xiaprojects/rb-cases/README.md

# RB-Avionics cases

3D-printable cases and mounts, and aluminium boxes, for
[RB-Avionics](https://www.rbavionics.com): open-source, open-design avionics for
experimental and ultralight aircraft and for flight simulator cockpits.

The printed designs are also published on Thingiverse:
[XIAPROJECTS designs](https://www.thingiverse.com/XIAPROJECTS/designs).

## Products

| Product | Hardware | Folder |
|---|---|---|
| RB-01: synthetic vision, autopilot, ADS-B, radio remote; round 80 mm display, or GlassCockpit with 8" and round displays | Raspberry Pi 5, Wisecoco or Waveshare display, DSI or HDMI | [RB-01](RB-01/) |
| RB-02: touch-screen SixPack for 57 mm and 80 mm panel holes | ESP32, Waveshare display | [RB-02](RB-02/) |
| RB-03: computer with autopilot, ADS-B and radio | Raspberry Pi Zero 2W | [RB-03](RB-03/) |
| RB-06: Android display, OLED or TFT | Raspberry Pi 5 with Android | [RB-06](RB-06/) |
| RB-07: commercial version, sold by Lammy | see [rbavionics.com](https://www.rbavionics.com) | [RB-07](RB-07/) |
| Flight simulator home cockpits: 3D-printable panels for RB instruments | RB-01, RB-02 family, RB-04, RB-05, RB-09 | [RB-Cockpits](RB-Cockpits/) |

RB-04 (engine monitoring) and RB-05 (Stratux traffic display) have no designs of
their own here.

## Designs

| Design | Product | Files | Author | License | Thingiverse |
|---|---|---|---|---|---|
| [3D SynthView](RB-01/3d-synthview-7162277/) | RB-01 | 12 STL | XIAPROJECTS | Personal use; commercial by agreement | [7162277](https://www.thingiverse.com/thing:7162277) |
| [F-16 sidestick grip](RB-01/f-16-sidestick-grip/) | RB-01 | 19 STL, 1 FCStd, 1 STEP | Spock | CC BY-NC-SA 4.0 | — |
| [GlassCockpit 8" unit](RB-01/glasscockpit-8/) | RB-01 | 3 STL, 1 DXF | RB-Avionics | Personal use; commercial by agreement | — |
| [GlassCockpit remote round display](RB-01/glasscockpit-round/) | RB-01 | 2 STL, 1 DXF | RB-Avionics | Personal use; commercial by agreement | — |
| [SixPack Box 80mm](RB-02/sixpack-box-80mm-7088576/) | RB-02 | 7 STL | XIAPROJECTS | Personal use; commercial by agreement | [7088576](https://www.thingiverse.com/thing:7088576) |
| [Front Install SixPack Box 80mm](RB-02/front-install-sixpack-box-80mm-7103368/) | RB-02 | 6 STL | XIAPROJECTS | Personal use; commercial by agreement | [7103368](https://www.thingiverse.com/thing:7103368) |
| [GPS mount V2](RB-02/gps-mount-v2-7169108/) | RB-02 | 2 STL | SeeCoryRun | CC BY-SA | [7169108](https://www.thingiverse.com/thing:7169108) |
| [Parrot GPS SixPack Box 80mm](RB-02/parrot-gps-sixpack-box-80mm-7208654/) | RB-02 | 2 STL | XIAPROJECTS | Personal use; commercial by agreement | [7208654](https://www.thingiverse.com/thing:7208654) |
| [SixPack Box 57mm 80mm Compact Edition](RB-02/sixpack-box-57mm-80mm-compact-edition-7228713/) | RB-02 | 2 STL | XIAPROJECTS | Personal use; commercial by agreement | [7228713](https://www.thingiverse.com/thing:7228713) |
| [Round case 57 mm, Waveshare ESP32-S3 AMOLED 1.75"](RB-02/round-case-amoled-1-75/) | RB-02 | 2 STL, 1 DXF | RB-Avionics | Personal use; commercial by agreement | — |
| [Printed case, Waveshare ESP32-S3 AMOLED 2.41"](RB-02/printed-case-amoled-2-41/) | RB-02 | 3 STL, 1 DXF | RB-Avionics | Personal use; commercial by agreement | — |
| [Aluminium Amazon box](RB-03/aluminium-amazon-box/) | RB-03 | off-the-shelf box | RB-Avionics | Personal use; commercial by agreement | — |
| [Aluminium box, Waveshare 8"](RB-06/aluminium-waveshare-8/) | RB-06 | 1 DXF | Sandro, RB-Avionics team | Personal use; commercial by agreement | — |
| [Printed case, Waveshare 8"](RB-06/printed-case-waveshare-8/) | RB-06 | 3 STL, 1 DXF | RB-Avionics | Personal use; commercial by agreement | — |
| [Printed case, Waveshare 6.25"](RB-06/printed-case-waveshare-6-25/) | RB-06 | 3 STL, 1 DXF | RB-Avionics | Personal use; commercial by agreement | — |
| [Printed case, Waveshare 5.5" AMOLED](RB-06/printed-case-waveshare-5-5-amoled/) | RB-06 | 3 STL, 1 DXF | RB-Avionics | Personal use; commercial by agreement | — |
| [Printed case, Waveshare 7" (C)](RB-06/printed-case-waveshare-7c/) | RB-06 | 3 STL, 1 DXF | RB-Avionics | Personal use; commercial by agreement | — |
| [Printed case, Waveshare 70H-1024600](RB-06/printed-case-waveshare-70h/) | RB-06 | 3 STL, 1 DXF | RB-Avionics | Personal use; commercial by agreement | — |
| [Printed case, Waveshare 7.9"](RB-06/printed-case-waveshare-7-9/) | RB-06 | 3 STL, 1 DXF | RB-Avionics | Personal use; commercial by agreement | — |
| [Printed case, Waveshare 13.3" AMOLED](RB-06/printed-case-waveshare-13-3-amoled/) | RB-06 | 6 STL, 1 DXF | RB-Avionics | Personal use; commercial by agreement | — |
| [Desktop pod](RB-Cockpits/desktop-pod/) | Cockpits | 4 STL, 1 DXF | RB-Avionics | Personal use; commercial by agreement | — |
| [Six-pack trainer](RB-Cockpits/six-pack-trainer/) | Cockpits | 13 STL, 1 DXF | RB-Avionics | Personal use; commercial by agreement | — |
| [Glass-cockpit rig](RB-Cockpits/glass-cockpit-rig/) | Cockpits | 14 STL, 3 DXF | RB-Avionics | Personal use; commercial by agreement | — |
| [Glider panel](RB-Cockpits/glider-panel/) | Cockpits | 6 STL, 1 DXF | RB-Avionics | Personal use; commercial by agreement | — |
| [Ultralight rehearsal](RB-Cockpits/ultralight-rehearsal/) | Cockpits | 11 STL, 1 DXF | RB-Avionics | Personal use; commercial by agreement | — |

To download every file of a design published on Thingiverse at once, use its
Thingiverse page.

## KiCad board templates

Every design but the round 1.75" case, which has no room for a board, and the
F-16 sidestick grip, whose switches are wired by hand, has a KiCad 9 project in
its `kicad/` folder: a board outline that fits the case,
mounting holes on the case's own bosses, and the case cut at the board plane
on the User.Drawings layer. Open it in KiCad and add your circuit;
each design README shows the board and its notes. The cockpits get a backplane
that sits behind the panel. The templates are generated by
[tools/kicad_templates.py](tools/kicad_templates.py) from the case STLs.

## Printing for aircraft

The cases are not certified aircraft parts. Printed parts installed in an
aircraft must withstand 100 °C in cruise on long flights: PLA, PETG, ABS and
ASA do not. Before printing, read [PRINTING.md](PRINTING.md) for the
materials, the print requirements and the oven test.

## Licenses

RB-Avionics designs are free for personal use; commercial use requires an
agreement with RB-Avionics. The full terms are in [LICENSE.md](LICENSE.md).

A design by another author keeps its own license in a `LICENSE.txt` in its
folder: the [GPS mount V2](RB-02/gps-mount-v2-7169108/) is by SeeCoryRun, under
CC BY-SA, and the [F-16 sidestick grip](RB-01/f-16-sidestick-grip/) is by Spock,
under CC BY-NC-SA 4.0. That grip is non-commercial: RB-Avionics cannot grant a
commercial agreement for it.

## Build guides and community

- RB-02 firmware and build tutorial: [rb-esp wiki](https://github.com/xiaprojects/rb-esp/wiki)
- RB-01 and the Raspberry Pi builds: [roastbeef wiki](https://github.com/xiaprojects/roastbeef/wiki)
- Discord: [RB-Avionics community](https://discord.gg/G4u6kjmrUG)

## Repository layout

```
RB-xx/                     one folder per product
  <design>-<thing id>/     a design published on Thingiverse
    README.md              description, parts, photos, author and license
    LICENSE.txt            only for designs by other authors
    files/                 STL files to print, DXF files to cut
    images/                renders and photos
    kicad/<project>/       KiCad board template for your own electronics
  <design>/                a design not on Thingiverse: same layout
RB-Cockpits/               simulator panels generated by tools/cockpit_panels.py
RB-0x/printed-case-*/      printed display cases generated by tools/display_cases.py
RB-02/round-case-*/        round instrument generated by tools/display_cases.py
RB-01/glasscockpit-*/      8" unit and remote round display generated by tools/display_cases.py
RB-01/f-16-sidestick-grip/ joystick grip generated by tools/joystick_grip.py
LICENSE.md                 license of the RB-Avionics designs
PRINTING.md                material requirements for parts that fly
tools/                     import, check and generator scripts
```
