xiaprojects/rb-cases/RB-01/README.md

# RB-01

Raspberry 5 with Wisecoco display or Waveshare

Supported display DSI or HDMI

## Designs

| Design | Files | Author | License |
|---|---|---|---|
| [3D SynthView](3d-synthview-7162277/): round 80 mm case | 12 STL | XIAPROJECTS | Personal use; commercial by agreement |
| [GlassCockpit 8" unit](glasscockpit-8/): the complete RB-01, one Pi 5 driving an 8" and a round display, with USB HAT, EMS HAT and every radio and antenna | 3 STL, 1 DXF | RB-Avionics | Personal use; commercial by agreement |
| [GlassCockpit remote round display](glasscockpit-round/): 80 mm round display and its driver board, 32 mm deep, on HDMI and USB cables from the 8" unit | 2 STL, 1 DXF | RB-Avionics | Personal use; commercial by agreement |
| [F-16 sidestick grip](f-16-sidestick-grip/): fighter-style joystick that drives RB-01 as a USB or Bluetooth keyboard | 19 STL, 1 FCStd, 1 STEP | Spock | CC BY-NC-SA 4.0, non-commercial |

Build guide: [roastbeef wiki, Build example 7: Round display](https://github.com/xiaprojects/roastbeef/wiki/Build-example-7:-Round-display)

Printing for an aircraft: the parts must withstand 100 °C in cruise on long flights, which rules out PLA, PETG, ABS and ASA. Read [PRINTING.md](../PRINTING.md).
