xiaprojects/rb-cases/RB-02/README.md

# RB-02

Supported Waveshare multiple format display ESP32

## Designs

| Design | Files | Author | License |
|---|---|---|---|
| [SixPack Box 80mm](sixpack-box-80mm-7088576/) | 7 STL | XIAPROJECTS | Personal use; commercial by agreement |
| [Front Install SixPack Box 80mm](front-install-sixpack-box-80mm-7103368/) | 6 STL | XIAPROJECTS | Personal use; commercial by agreement |
| [GPS mount V2](gps-mount-v2-7169108/): NEO-7M GPS shelf for the ESP32-S3 2.8" panel | 2 STL | SeeCoryRun | CC BY-SA |
| [Parrot GPS SixPack Box 80mm](parrot-gps-sixpack-box-80mm-7208654/) | 2 STL: 80 mm and 57 mm | XIAPROJECTS | Personal use; commercial by agreement |
| [SixPack Box 57mm 80mm Compact Edition](sixpack-box-57mm-80mm-compact-edition-7228713/) | 2 STL | XIAPROJECTS | Personal use; commercial by agreement |
| [Round case 57 mm, Waveshare ESP32-S3 AMOLED 1.75"](round-case-amoled-1-75/): shell and cap behind the panel, GPS hood on top | 2 STL, 1 DXF | RB-Avionics | Personal use; commercial by agreement |
| [Printed case, Waveshare ESP32-S3 AMOLED 2.41"](printed-case-amoled-2-41/): the RB-06 honeycomb case for this rectangular ESP32 display, mounted from the front of the panel | 3 STL, 1 DXF | RB-Avionics | Personal use; commercial by agreement |

57 mm and 80 mm are the standard round instrument panel holes (2¼" and 3⅛").

Build guide and firmware: [rb-esp wiki](https://github.com/xiaprojects/rb-esp/wiki)

Printing for an aircraft: the parts must withstand 100 °C in cruise on long flights, which rules out PLA, PETG, ABS and ASA. Read [PRINTING.md](../PRINTING.md).
