xiaprojects/rb-cases/RB-06/README.md

# RB-06

Big display OLED or TFT powered by Raspberry 5 with Android

## Designs

| Design | Files | Author | License |
|---|---|---|---|
| [Aluminium box, Waveshare 8"](aluminium-waveshare-8/): folded sheet aluminium | 1 DXF | Sandro, RB-Avionics team | Personal use; commercial by agreement |
| [Printed case, Waveshare 8"](printed-case-waveshare-8/): honeycomb case for the 8DP-CAPLCD with the Pi 5 and an AHRS plane, mounted from the front of the panel | 3 STL, 1 DXF | RB-Avionics | Personal use; commercial by agreement |
| [Printed case, Waveshare 6.25"](printed-case-waveshare-6-25/): the same case for the 6.25inch 720x1560 LCD, in landscape | 3 STL, 1 DXF | RB-Avionics | Personal use; commercial by agreement |
| [Printed case, Waveshare 5.5" AMOLED](printed-case-waveshare-5-5-amoled/): the same case for the 5.5inch HDMI AMOLED, with a plug bay above the display | 3 STL, 1 DXF | RB-Avionics | Personal use; commercial by agreement |
| [Printed case, Waveshare 7" (C)](printed-case-waveshare-7c/): the same case for the 7inch HDMI LCD (C), with a plug bay on the right | 3 STL, 1 DXF | RB-Avionics | Personal use; commercial by agreement |
| [Printed case, Waveshare 70H-1024600](printed-case-waveshare-70h/): the same case for the thin 7" 70H-1024600 (CT) and its HDMI adapter board | 3 STL, 1 DXF | RB-Avionics | Personal use; commercial by agreement |
| [Printed case, Waveshare 7.9"](printed-case-waveshare-7-9/): the same case for the 7.9inch HDMI LCD strip | 3 STL, 1 DXF | RB-Avionics | Personal use; commercial by agreement |
| [Printed case, Waveshare 13.3" AMOLED](printed-case-waveshare-13-3-amoled/): the same case for the 13.3inch FHD AMOLED monitor, each part in two pieces | 6 STL, 1 DXF | RB-Avionics | Personal use; commercial by agreement |
