xiaprojects/rb-cases/RB-03/README.md

# RB-03

Computer with autopilot, ADS-B and radio.

## Designs

| Design | Files | Author | License |
|---|---|---|---|
| [Aluminium Amazon box](aluminium-amazon-box/): off-the-shelf 122 × 66 × 39.5 mm box for a Raspberry Pi Zero 2W with GPS and ADS-B receiver | none, bought and drilled | RB-Avionics | Personal use; commercial by agreement |
