xiaprojects/rb-cases/RB-01/3d-synthview-7162277/files/RB01.05_-_Base_B_Meshed.stl

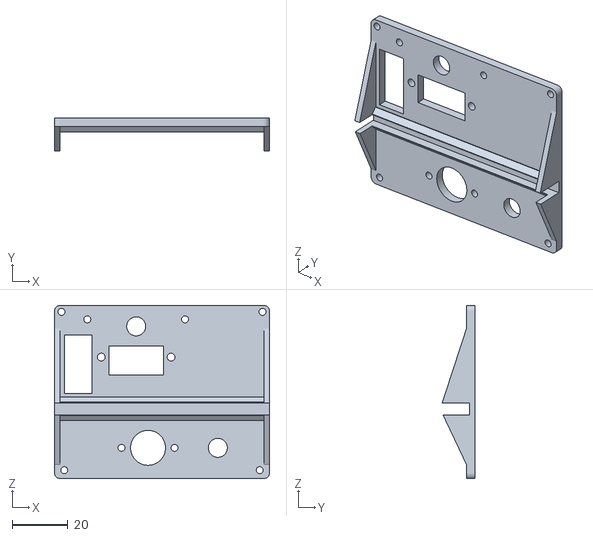
[picture p54: CAD file, 2026-10-31]
RB-01/3d-synthview-7162277/files/RB01.05_-_Base_B_Meshed.stl
77.0 x 11.7 x 62.0
