xiaprojects/rb-cases/RB-01/glasscockpit-8/files/rb01-glass-8-rear-cover.stl

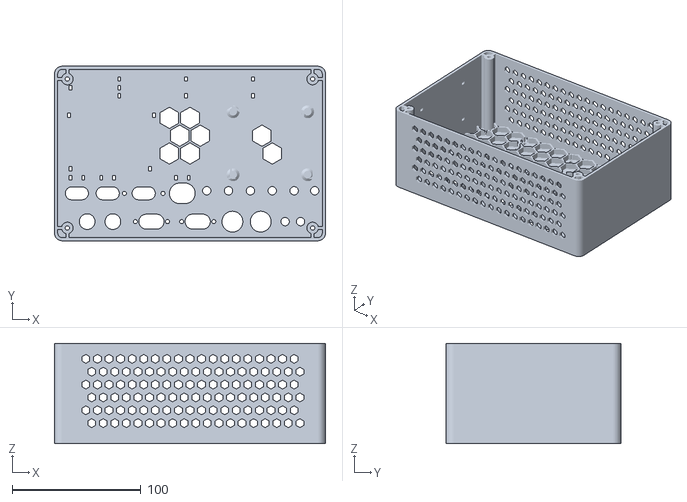
[picture p55: CAD file, 2026-11-07]
RB-01/glasscockpit-8/files/rb01-glass-8-rear-cover.stl
210.8 x 135.8 x 78.0
