xiaprojects/rb-cases/RB-01/glasscockpit-round/files/rb01-glass-round-case.FCStd

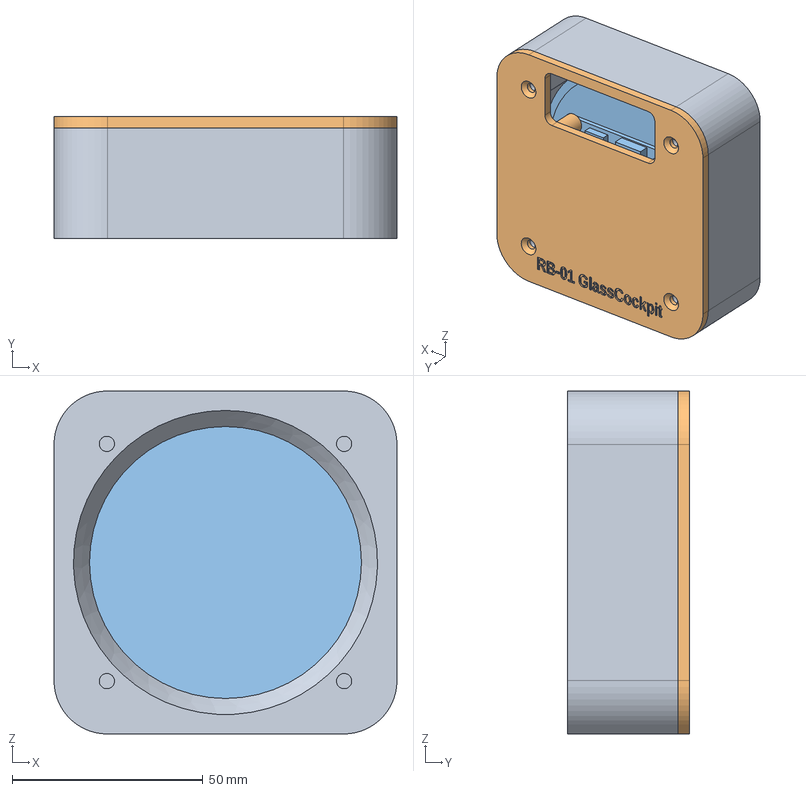
[picture p56: CAD file, 2026-11-07]
RB-01/glasscockpit-round/files/rb01-glass-round-case.FCStd
90.0 x 32.0 x 90.0 mm
Cap
Display
