xiaprojects/rb-cases/RB-02/front-install-sixpack-box-80mm-7103368/files/RB02C_-_front_ring_Meshed.stl

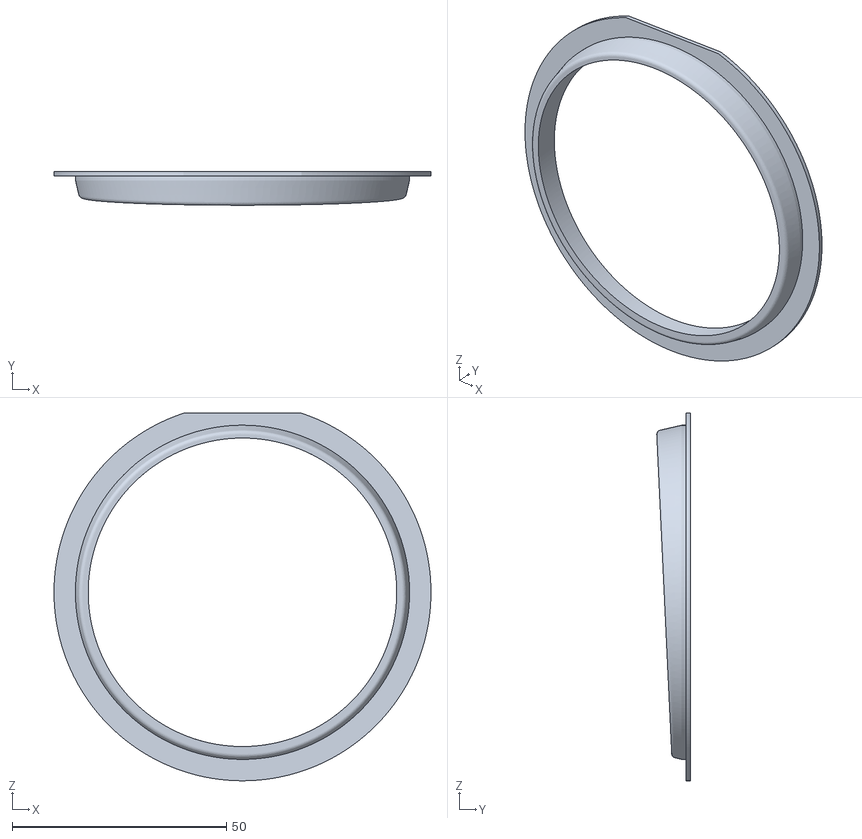
[picture p57: CAD file, 2026-10-31]
RB-02/front-install-sixpack-box-80mm-7103368/files/RB02C_-_front_ring_Meshed.stl
88.0 x 7.83 x 85.8
