xiaprojects/rb-cases/RB-02/gps-mount-v2-7169108/files/GPSstandoffV2.stl

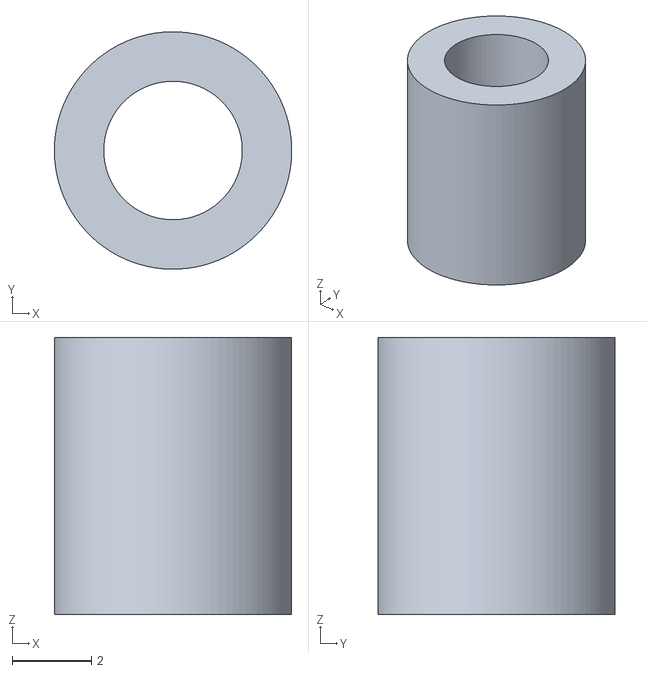
[picture p58: CAD file, 2026-10-31]
RB-02/gps-mount-v2-7169108/files/GPSstandoffV2.stl
6.00 x 6.00 x 7.00
