xiaprojects/rb-cases/RB-02/parrot-gps-sixpack-box-80mm-7208654/files/RB02B_-_2.1_-_57mm.stl

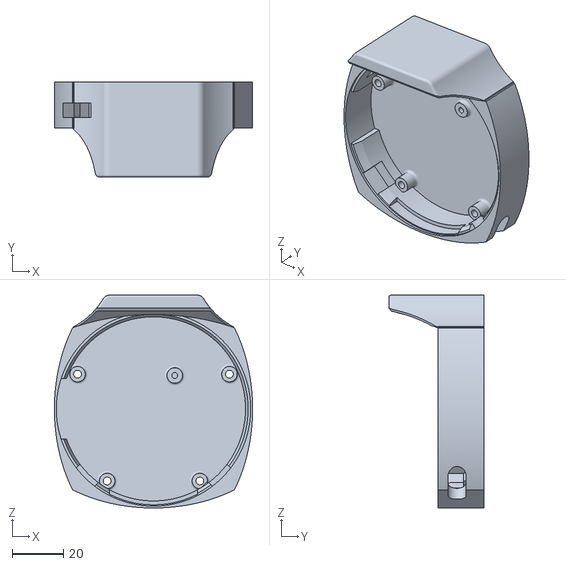
[picture p59: CAD file, 2026-10-31]
RB-02/parrot-gps-sixpack-box-80mm-7208654/files/RB02B_-_2.1_-_57mm.stl
77.0 x 37.0 x 82.7
