xiaprojects/rb-cases/RB-02/printed-case-amoled-2-41/files/rb02-amoled241-carrier.stl

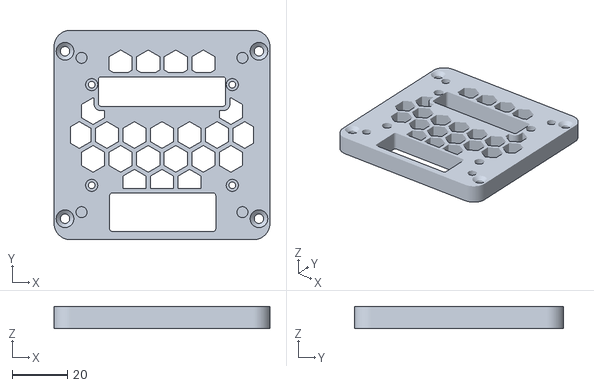
[picture p60: CAD file, 2026-11-01]
RB-02/printed-case-amoled-2-41/files/rb02-amoled241-carrier.stl
78.4 x 76.0 x 8.00
