xiaprojects/rb-cases/RB-02/round-case-amoled-1-75/files/rb02-amoled175-panel-cutout.dxf

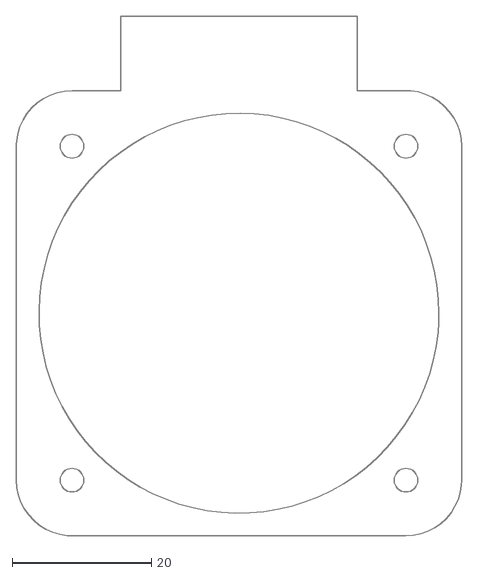
[picture p61: CAD file, 2026-11-01]
RB-02/round-case-amoled-1-75/files/rb02-amoled175-panel-cutout.dxf
64.0 x 74.7
