xiaprojects/rb-cases/RB-02/sixpack-box-57mm-80mm-compact-edition-7228713/files/RB02Bep50_2.2.stl

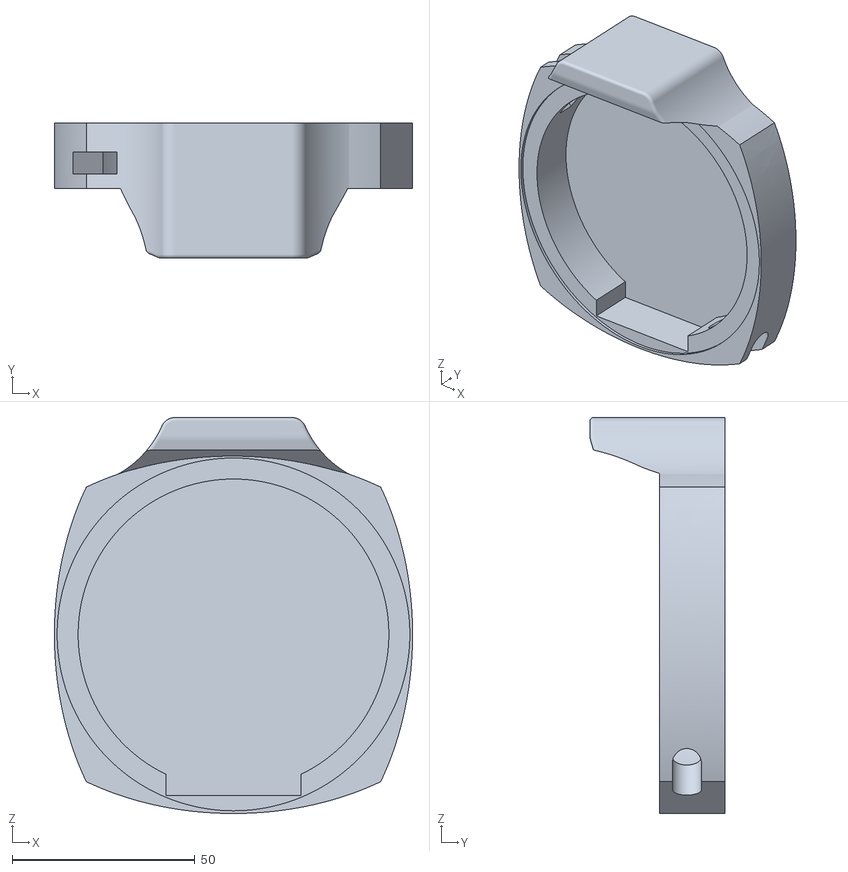
[picture p62: CAD file, 2026-10-31]
RB-02/sixpack-box-57mm-80mm-compact-edition-7228713/files/RB02Bep50_2.2.stl
98.0 x 37.0 x 108.3
