xiaprojects/rb-cases/RB-06/aluminium-waveshare-8/files/RB_Box_WS8inch_v3.dxf

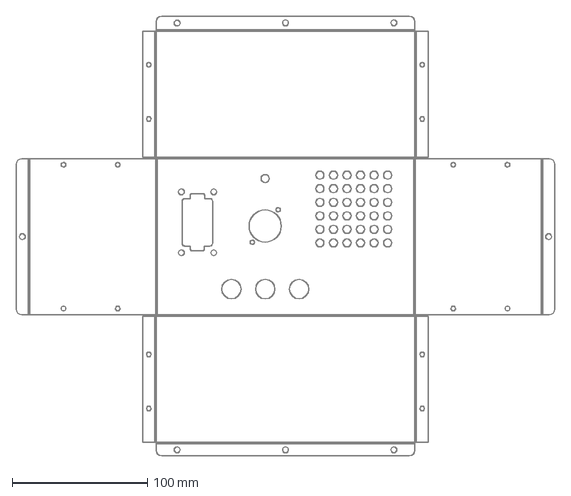
[picture p64: CAD file, 2026-10-31]
RB-06/aluminium-waveshare-8/files/RB_Box_WS8inch_v3.dxf
397.5 x 324.7 mm
