xiaprojects/rb-cases/RB-06/printed-case-waveshare-13-3-amoled/files/rb06-133amoled-bezel-left.stl

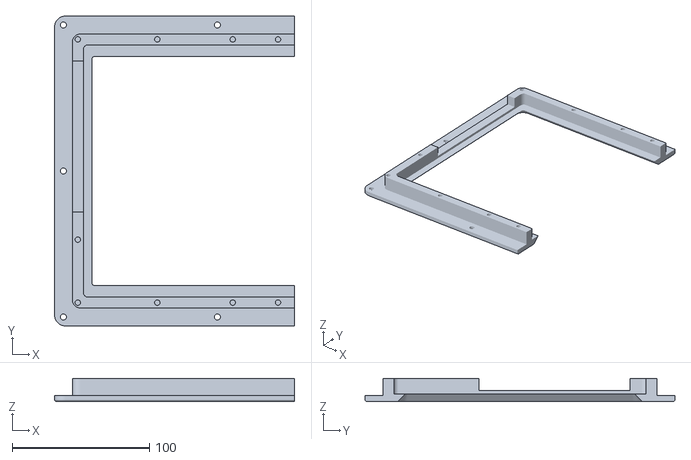
[picture p65: CAD file, 2026-11-01]
RB-06/printed-case-waveshare-13-3-amoled/files/rb06-133amoled-bezel-left.stl
174.9 x 225.8 x 16.9
