xiaprojects/rb-cases/RB-06/printed-case-waveshare-6-25/files/rb06-625-case.FCStd

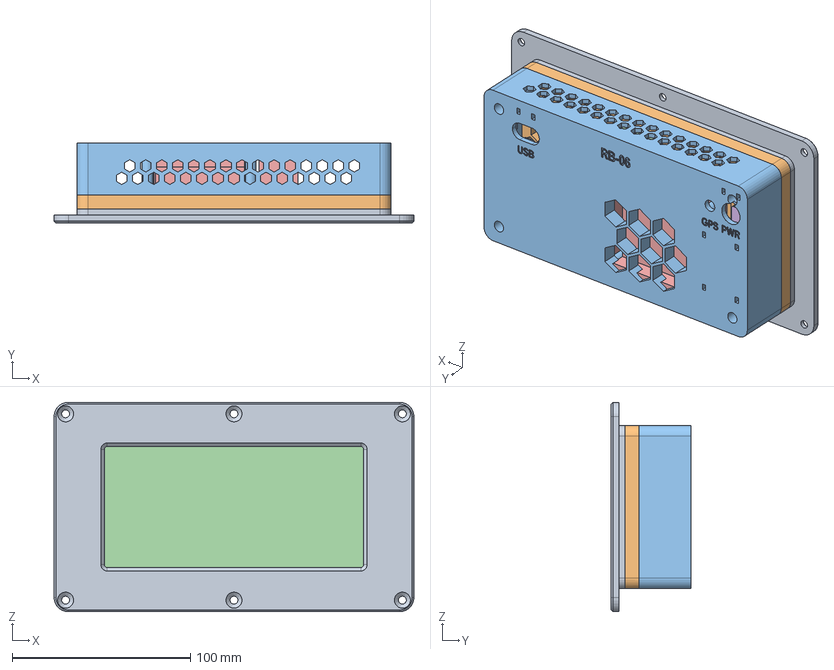
[picture p67: CAD file, 2026-11-01]
RB-06/printed-case-waveshare-6-25/files/rb06-625-case.FCStd
202.0 x 44.8 x 117.5 mm
Bezel
Carrier
Rearcover
Display
RaspberryPi5
AHRS
