xiaprojects/rb-cases/RB-06/printed-case-waveshare-7-9/files/rb06-79-carrier.stl

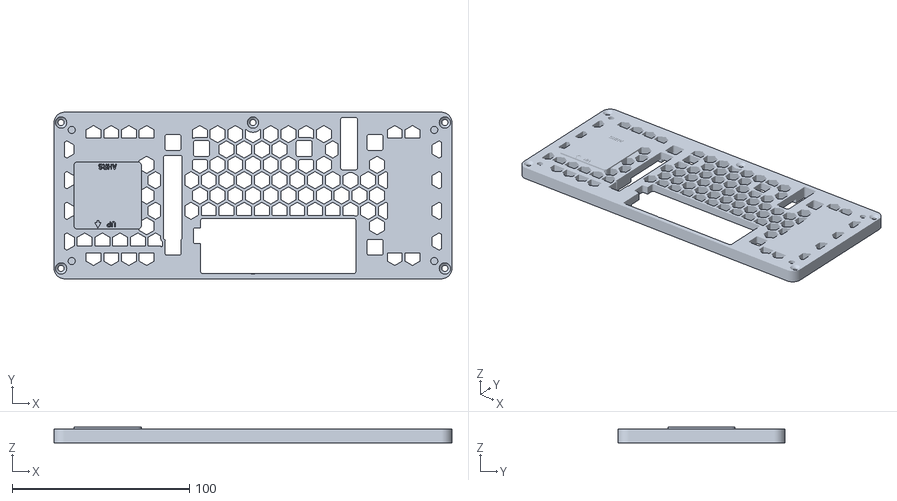
[picture p68: CAD file, 2026-11-01]
RB-06/printed-case-waveshare-7-9/files/rb06-79-carrier.stl
224.6 x 94.0 x 9.00
