xiaprojects/rb-cases/RB-06/printed-case-waveshare-70h/files/rb06-70h-rear-cover.stl

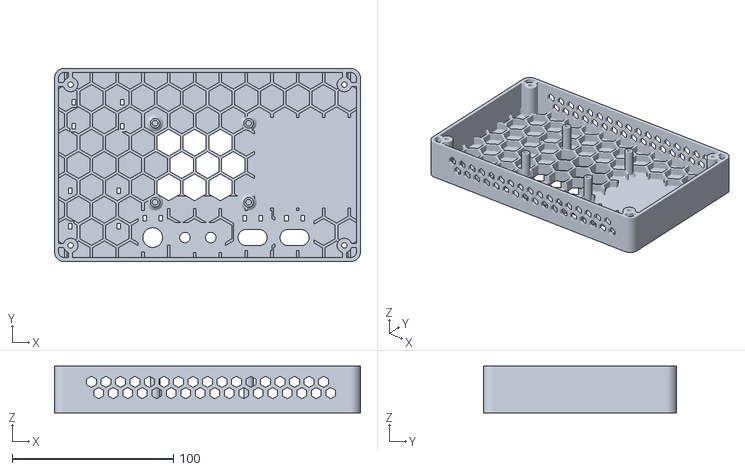
[picture p69: CAD file, 2026-11-01]
RB-06/printed-case-waveshare-70h/files/rb06-70h-rear-cover.stl
189.8 x 119.8 x 29.1
