xiaprojects/rb-cases/RB-06/printed-case-waveshare-7c/files/rb06-7c-carrier.stl

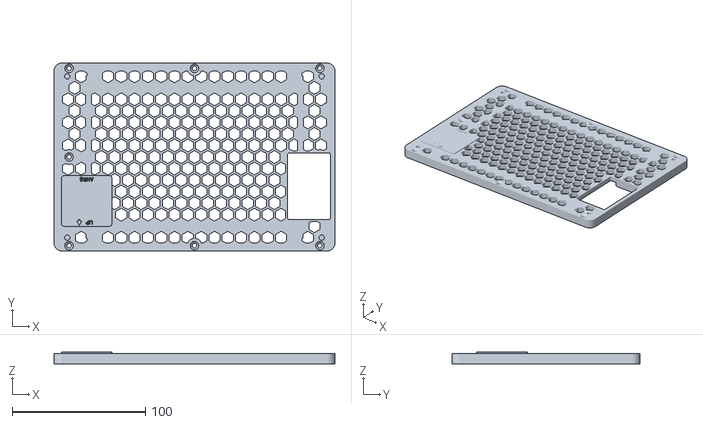
[picture p70: CAD file, 2026-11-01]
RB-06/printed-case-waveshare-7c/files/rb06-7c-carrier.stl
211.0 x 141.1 x 9.00
