xiaprojects/rb-cases/RB-06/printed-case-waveshare-8/files/rb06-8dp-case.FCStd

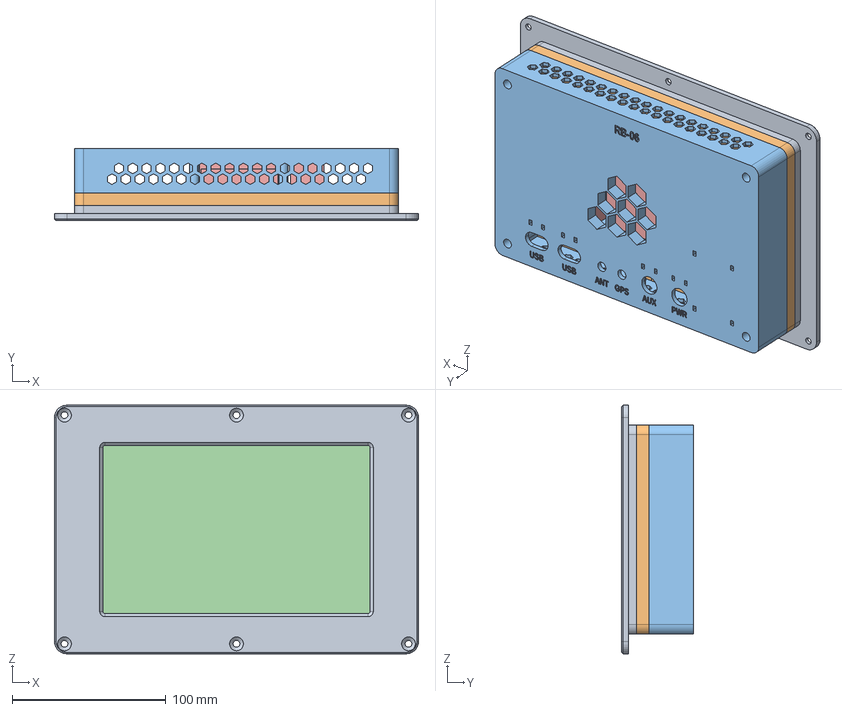
[picture p71: CAD file, 2026-11-01]
RB-06/printed-case-waveshare-8/files/rb06-8dp-case.FCStd
236.8 x 47.0 x 161.8 mm
Bezel
Carrier
Rearcover
Display
RaspberryPi5
AHRS
