xiaprojects/rb-cases/RB-Cockpits/desktop-pod/files/desktop-pod-C1.stl

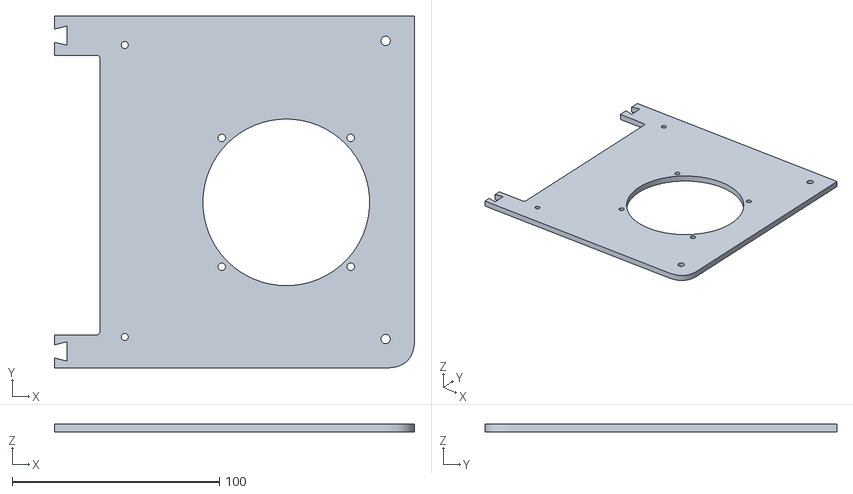
[picture p72: CAD file, 2026-10-31]
RB-Cockpits/desktop-pod/files/desktop-pod-C1.stl
174.0 x 170.0 x 4.00
