xiaprojects/rb-cases/RB-Cockpits/glass-cockpit-rig/files/glass-cockpit-rig-right.dxf

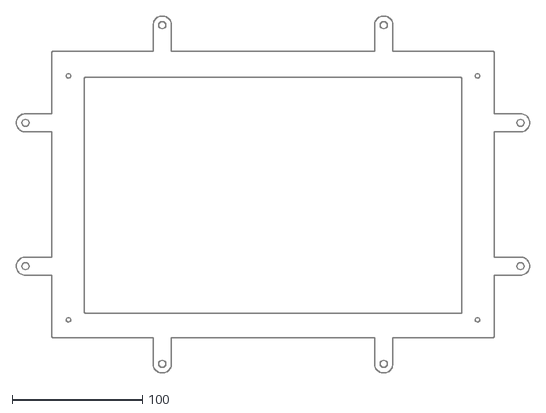
[picture p73: CAD file, 2026-10-31]
RB-Cockpits/glass-cockpit-rig/files/glass-cockpit-rig-right.dxf
394.0 x 274.0
