xiaprojects/rb-cases/RB-Cockpits/glider-panel/files/glider-panel-A1.stl

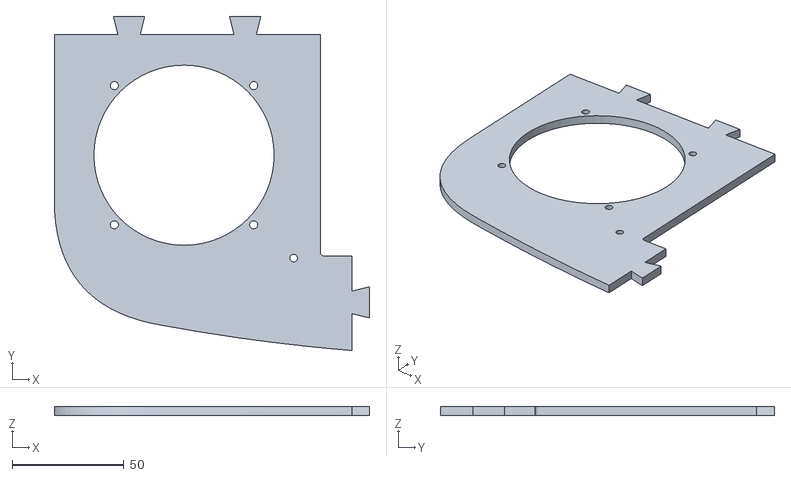
[picture p74: CAD file, 2026-10-31]
RB-Cockpits/glider-panel/files/glider-panel-A1.stl
141.0 x 149.3 x 4.00
