xiaprojects/rb-cases/RB-Cockpits/six-pack-trainer/files/six-pack-trainer-F1.stl

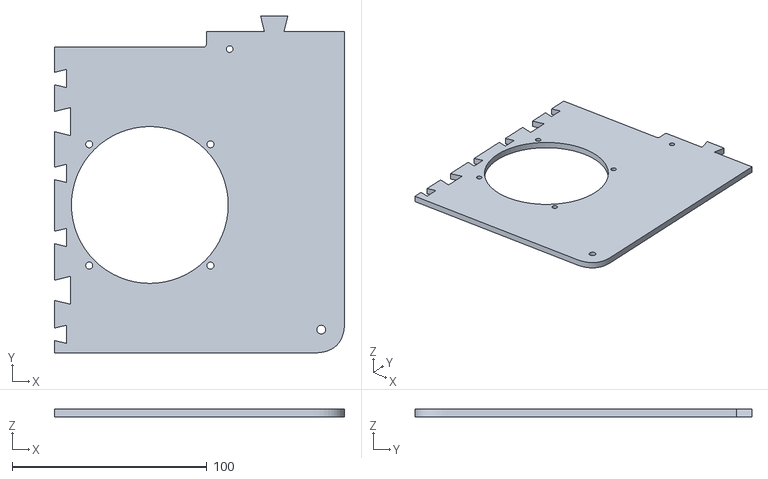
[picture p75: CAD file, 2026-10-31]
RB-Cockpits/six-pack-trainer/files/six-pack-trainer-F1.stl
149.0 x 173.0 x 4.00
