xiaprojects/rb-cases/RB-Cockpits/ultralight-rehearsal/files/ultralight-rehearsal-E2.stl

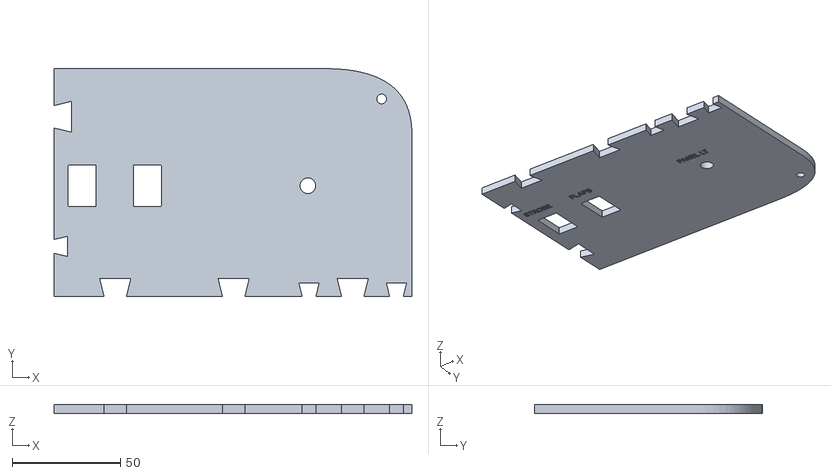
[picture p76: CAD file, 2026-10-31]
RB-Cockpits/ultralight-rehearsal/files/ultralight-rehearsal-E2.stl
165.0 x 105.0 x 4.00
