xiaprojects/rb-cases/RB-01/3d-synthview-7162277/files/RB01.05_-_Flangia_Meshed.stl

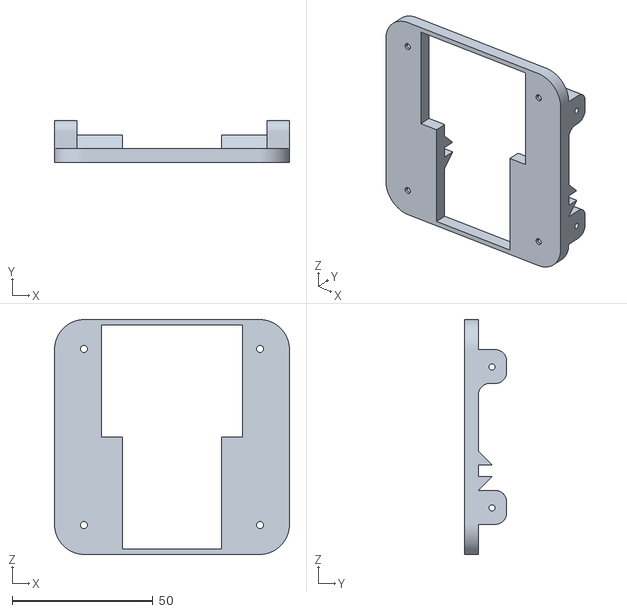
[picture p77: CAD file, 2026-10-31]
RB-01/3d-synthview-7162277/files/RB01.05_-_Flangia_Meshed.stl
83.4 x 15.0 x 83.4
