xiaprojects/rb-cases/RB-01/glasscockpit-8/files/rb01-glass-8-case.FCStd

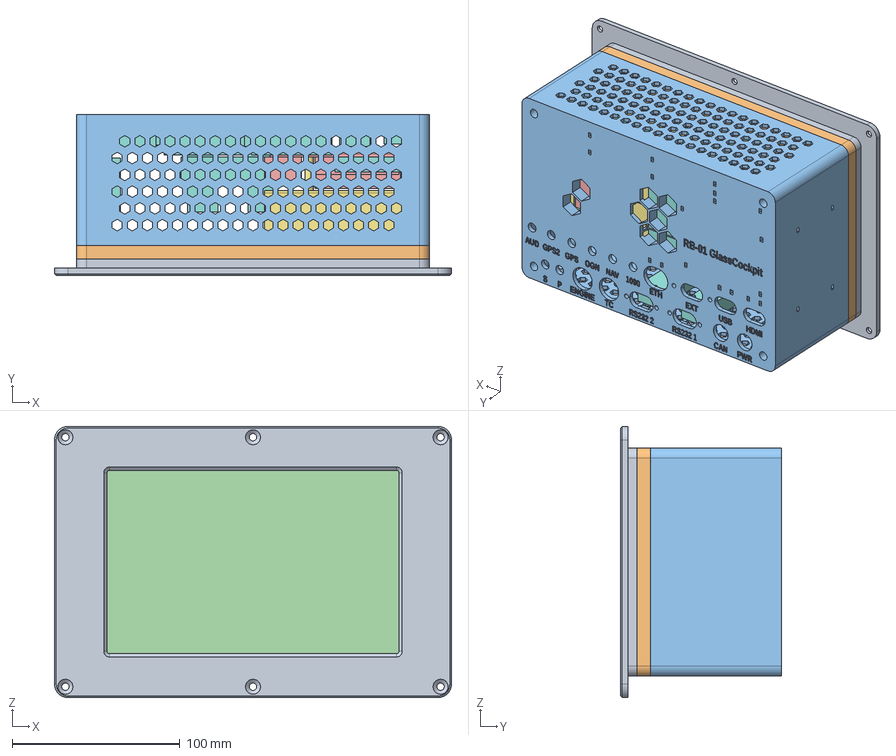
[picture p78: CAD file, 2026-11-07]
RB-01/glasscockpit-8/files/rb01-glass-8-case.FCStd
236.8 x 95.9 x 161.8 mm
Bezel
Carrier
Rearcover
Display
RaspberryPi5
AHRS
Stack
Rooms
