xiaprojects/rb-cases/RB-01/glasscockpit-round/files/rb01-glass-round-cap.stl

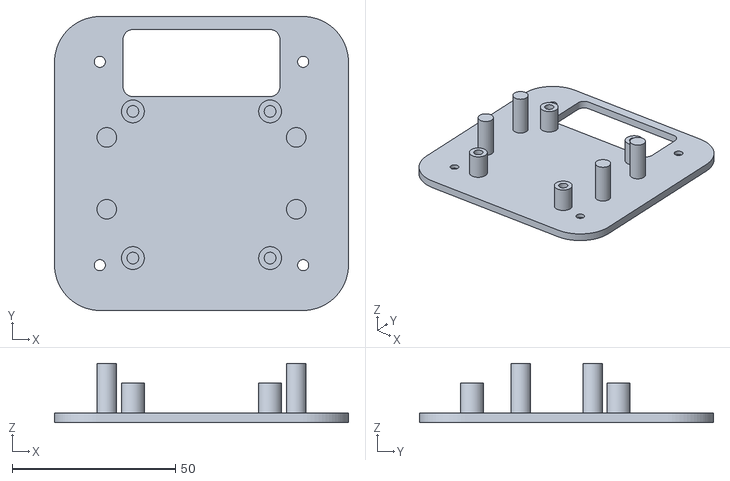
[picture p79: CAD file, 2026-11-07]
RB-01/glasscockpit-round/files/rb01-glass-round-cap.stl
90.0 x 90.0 x 18.2
