xiaprojects/rb-cases/RB-02/front-install-sixpack-box-80mm-7103368/files/RB02D_-_template_ESP_Meshed.stl

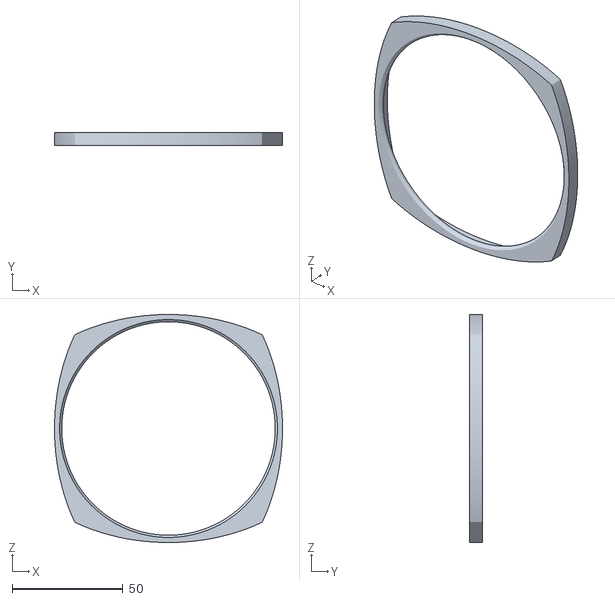
[picture p80: CAD file, 2026-10-31]
RB-02/front-install-sixpack-box-80mm-7103368/files/RB02D_-_template_ESP_Meshed.stl
103.0 x 6.00 x 103.0
