xiaprojects/rb-cases/RB-02/gps-mount-v2-7169108/files/GPSmountN7v1.stl

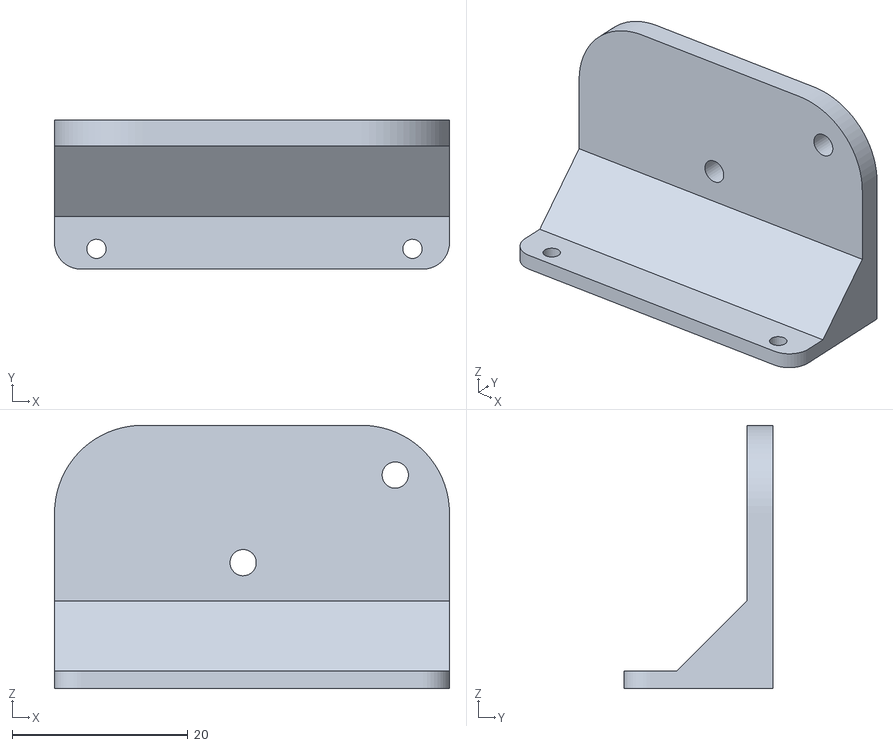
[picture p81: CAD file, 2026-10-31]
RB-02/gps-mount-v2-7169108/files/GPSmountN7v1.stl
45.0 x 17.0 x 30.0
