xiaprojects/rb-cases/RB-02/printed-case-amoled-2-41/files/rb02-amoled241-case.FCStd

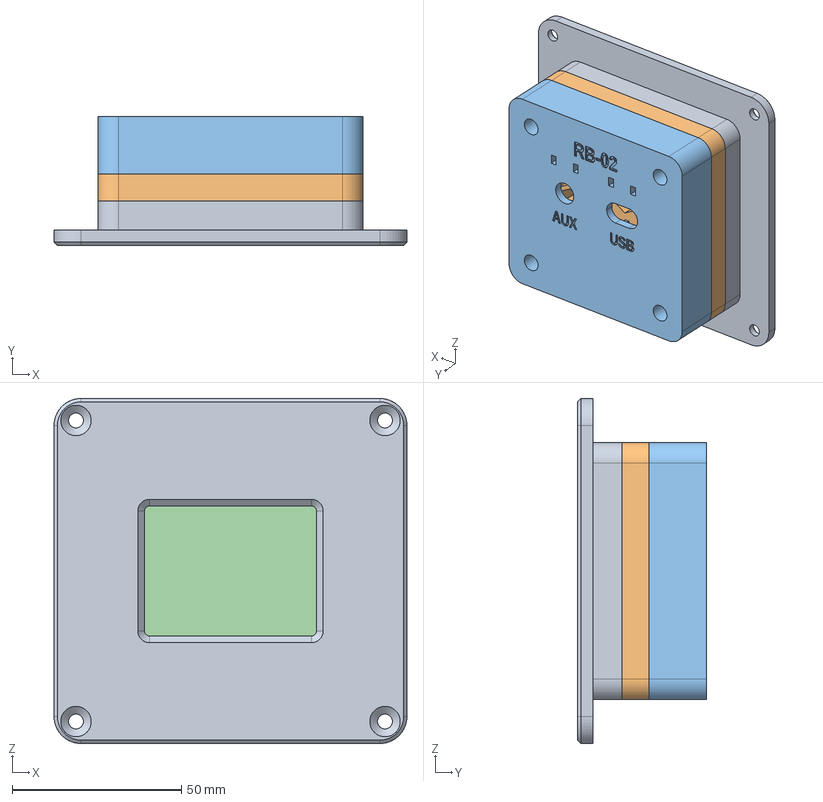
[picture p82: CAD file, 2026-11-01]
RB-02/printed-case-amoled-2-41/files/rb02-amoled241-case.FCStd
104.4 x 38.1 x 102.0 mm
Bezel
Carrier
Rearcover
Display
