xiaprojects/rb-cases/RB-02/round-case-amoled-1-75/files/rb02-amoled175-cap.stl

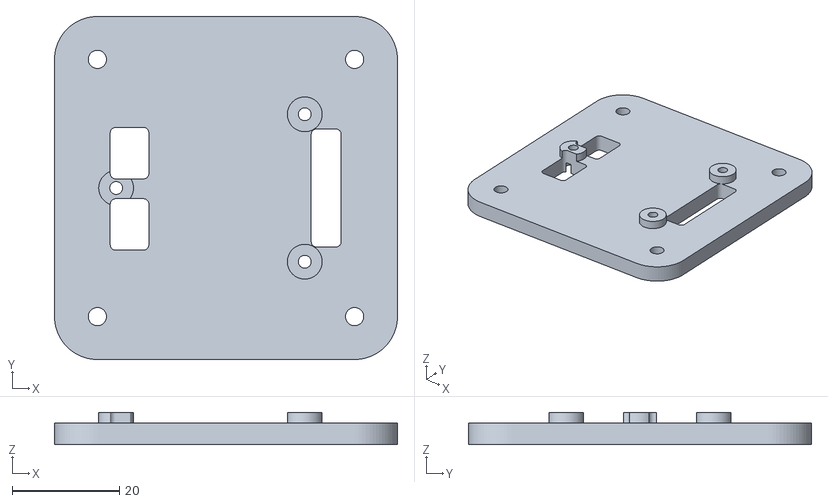
[picture p83: CAD file, 2026-11-01]
RB-02/round-case-amoled-1-75/files/rb02-amoled175-cap.stl
64.0 x 64.0 x 6.00
