xiaprojects/rb-cases/RB-02/sixpack-box-57mm-80mm-compact-edition-7228713/files/RB02BEP80_1.1.stl

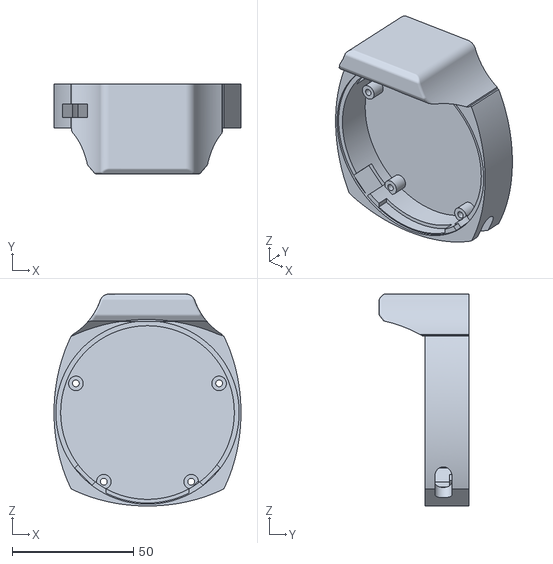
[picture p84: CAD file, 2026-10-31]
RB-02/sixpack-box-57mm-80mm-compact-edition-7228713/files/RB02BEP80_1.1.stl
77.0 x 37.0 x 87.3
