xiaprojects/rb-cases/RB-02/sixpack-box-80mm-7088576/files/RB02.02_Power_Cup_Meshed.stl

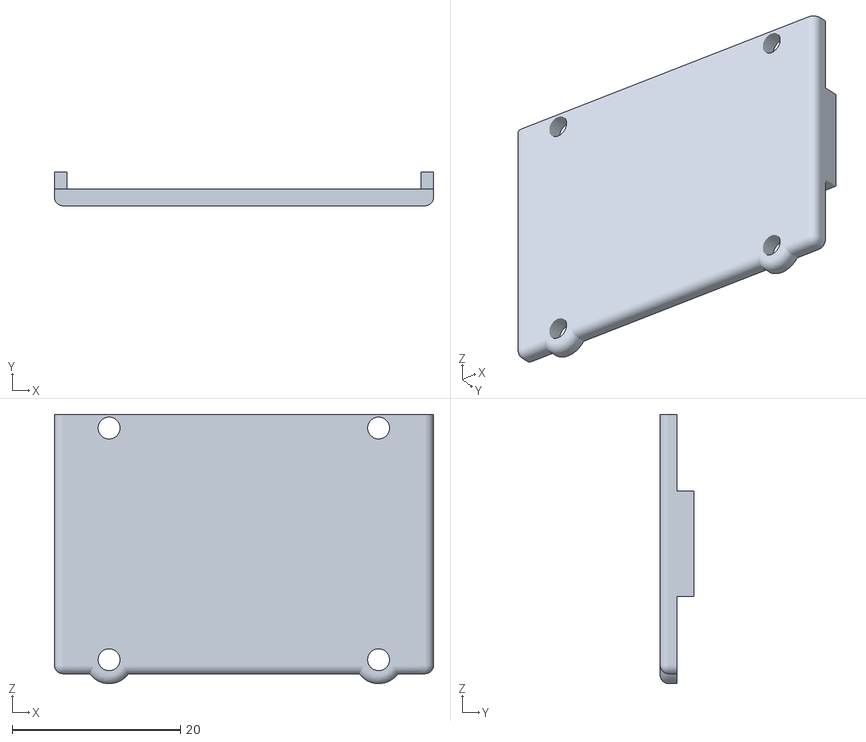
[picture p85: CAD file, 2026-10-31]
RB-02/sixpack-box-80mm-7088576/files/RB02.02_Power_Cup_Meshed.stl
45.0 x 4.00 x 32.0
