xiaprojects/rb-cases/RB-06/printed-case-waveshare-5-5-amoled/files/rb06-55amoled-panel-cutout.dxf

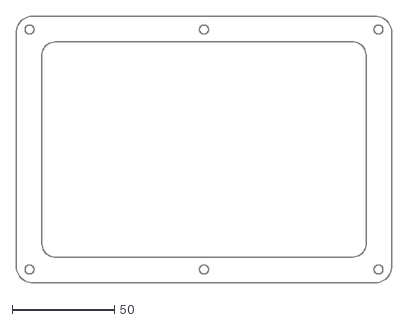
[picture p87: CAD file, 2026-11-01]
RB-06/printed-case-waveshare-5-5-amoled/files/rb06-55amoled-panel-cutout.dxf
183.2 x 130.0
