xiaprojects/rb-cases/RB-06/printed-case-waveshare-6-25/files/rb06-625-rear-cover.stl

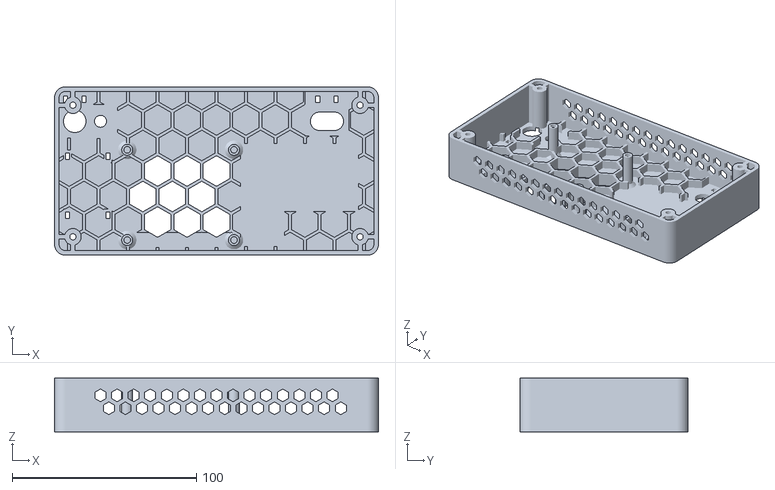
[picture p88: CAD file, 2026-11-01]
RB-06/printed-case-waveshare-6-25/files/rb06-625-rear-cover.stl
176.0 x 91.5 x 29.1
