xiaprojects/rb-cases/RB-06/printed-case-waveshare-7-9/files/rb06-79-rear-cover.stl

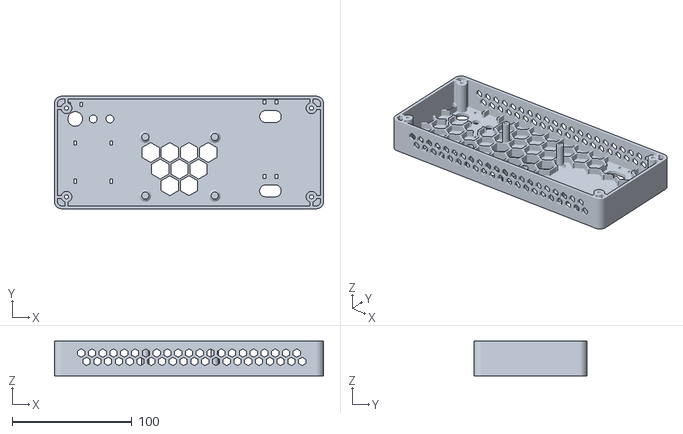
[picture p89: CAD file, 2026-11-01]
RB-06/printed-case-waveshare-7-9/files/rb06-79-rear-cover.stl
224.6 x 94.0 x 29.1
