xiaprojects/rb-cases/RB-06/printed-case-waveshare-70h/files/rb06-70h-panel-cutout.dxf

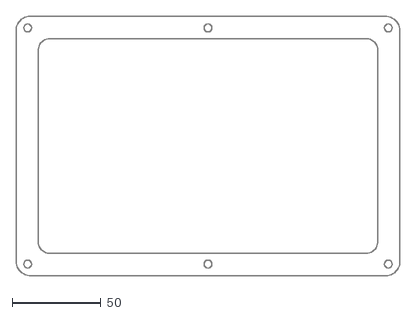
[picture p90: CAD file, 2026-11-01]
RB-06/printed-case-waveshare-70h/files/rb06-70h-panel-cutout.dxf
215.8 x 145.8
