xiaprojects/rb-cases/RB-06/printed-case-waveshare-7c/files/rb06-7c-bezel.stl

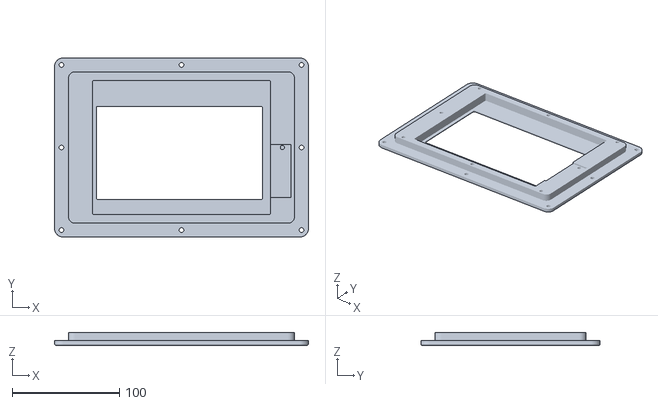
[picture p91: CAD file, 2026-11-01]
RB-06/printed-case-waveshare-7c/files/rb06-7c-bezel.stl
237.0 x 167.1 x 12.2
