xiaprojects/rb-cases/RB-06/printed-case-waveshare-8/files/rb06-8dp-rear-cover.stl

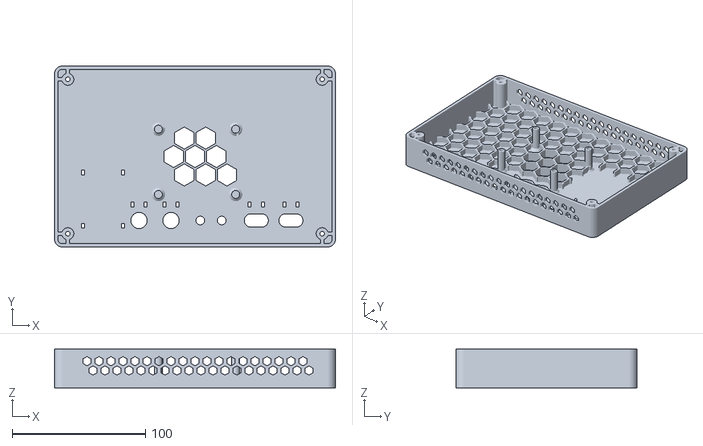
[picture p92: CAD file, 2026-11-01]
RB-06/printed-case-waveshare-8/files/rb06-8dp-rear-cover.stl
210.8 x 135.8 x 29.1
