xiaprojects/rb-cases/RB-Cockpits/desktop-pod/files/desktop-pod-A1.stl

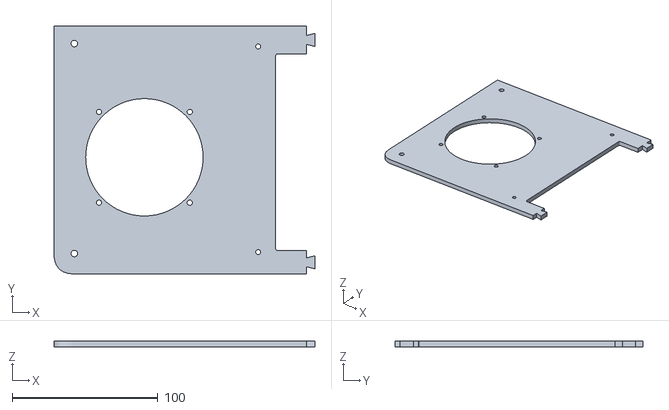
[picture p93: CAD file, 2026-10-31]
RB-Cockpits/desktop-pod/files/desktop-pod-A1.stl
179.0 x 170.0 x 4.00
