xiaprojects/rb-cases/RB-Cockpits/glass-cockpit-rig/files/glass-cockpit-rig.FCStd

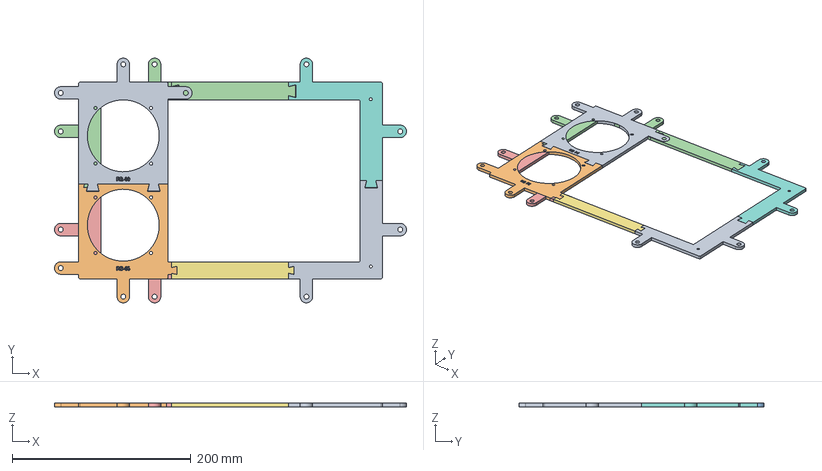
[picture p94: CAD file, 2026-10-31]
RB-Cockpits/glass-cockpit-rig/files/glass-cockpit-rig.FCStd
394.0 x 274.0 x 4.00 mm
Left
Left_A1
Left_A2
Left_B1
Left_B2
Left_C1
Left_C2
Centre
Centre_A1
Centre_A2
Right
Right_A1
Right_A2
Right_B1
Right_B2
Right_C1
Right_C2
