xiaprojects/rb-cases/RB-Cockpits/glider-panel/files/glider-panel-B2.stl

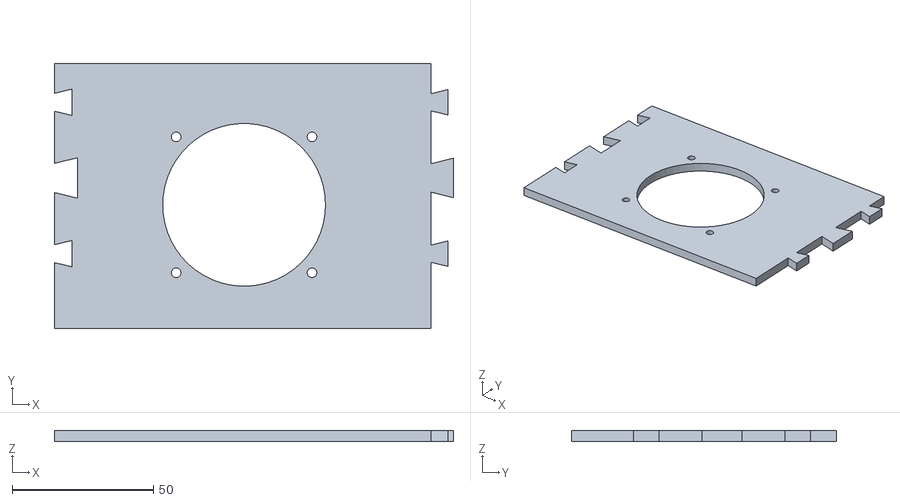
[picture p95: CAD file, 2026-10-31]
RB-Cockpits/glider-panel/files/glider-panel-B2.stl
141.0 x 93.8 x 4.00
