xiaprojects/rb-cases/RB-Cockpits/six-pack-trainer/files/six-pack-trainer-D1.stl

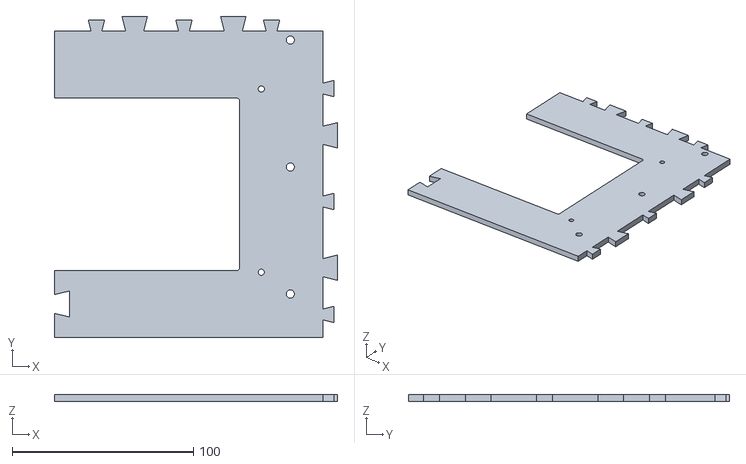
[picture p96: CAD file, 2026-10-31]
RB-Cockpits/six-pack-trainer/files/six-pack-trainer-D1.stl
156.0 x 177.0 x 4.00
