xiaprojects/rb-cases/RB-Cockpits/ultralight-rehearsal/files/ultralight-rehearsal-C2.stl

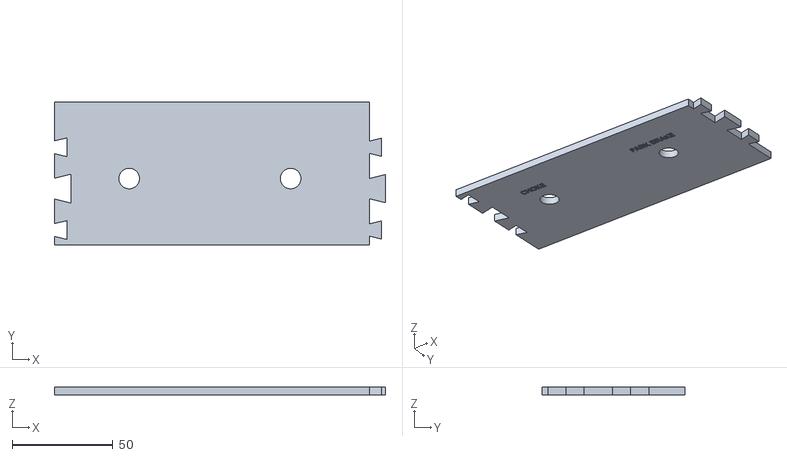
[picture p97: CAD file, 2026-10-31]
RB-Cockpits/ultralight-rehearsal/files/ultralight-rehearsal-C2.stl
164.0 x 71.0 x 4.00
