xiaprojects/rb-cases/RB-01/3d-synthview-7162277/files/RB01_supporto_antenna_ADSB_Meshed.stl

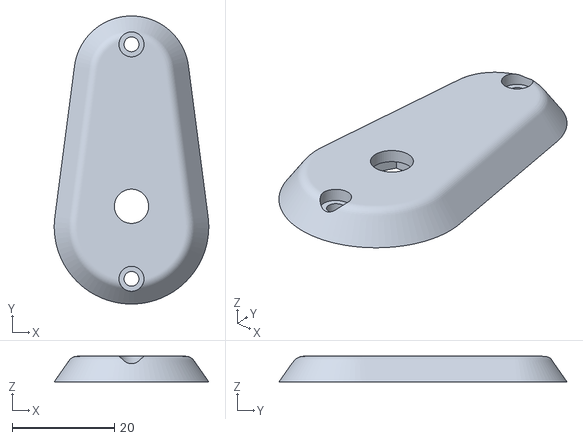
[picture p98: CAD file, 2026-10-31]
RB-01/3d-synthview-7162277/files/RB01_supporto_antenna_ADSB_Meshed.stl
30.2 x 56.4 x 5.00
