xiaprojects/rb-cases/RB-01/glasscockpit-8/files/rb01-glass-8-carrier.stl

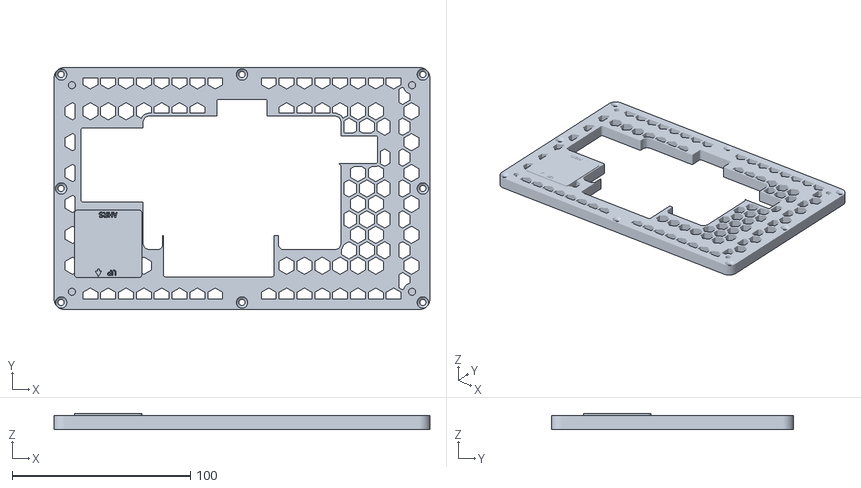
[picture p99: CAD file, 2026-11-07]
RB-01/glasscockpit-8/files/rb01-glass-8-carrier.stl
210.8 x 135.8 x 9.00
