xiaprojects/rb-cases/RB-01/glasscockpit-round/files/rb01-glass-round-panel-cutout.dxf

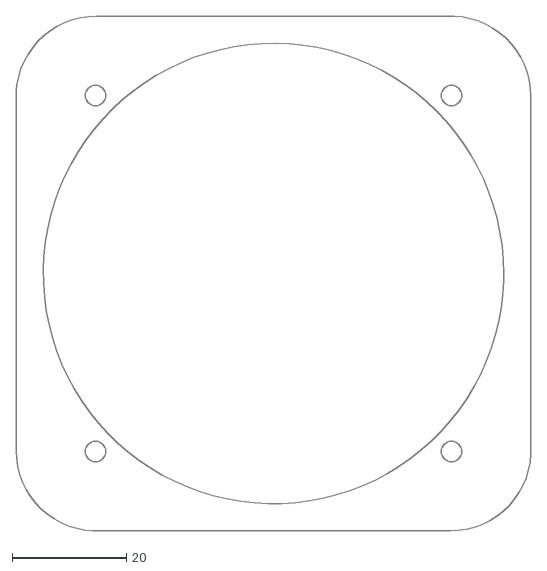
[picture p100: CAD file, 2026-11-07]
RB-01/glasscockpit-round/files/rb01-glass-round-panel-cutout.dxf
90.0 x 90.0
