xiaprojects/rb-cases/RB-02/front-install-sixpack-box-80mm-7103368/files/RB02C_-_GPS_lock_Meshed.stl

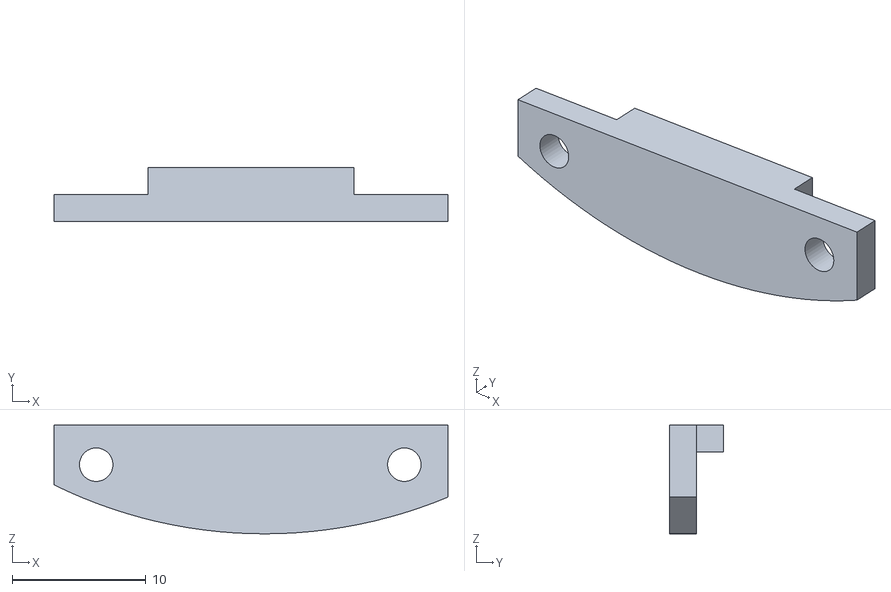
[picture p101: CAD file, 2026-10-31]
RB-02/front-install-sixpack-box-80mm-7103368/files/RB02C_-_GPS_lock_Meshed.stl
29.4 x 4.00 x 8.11
