xiaprojects/rb-cases/RB-02/printed-case-amoled-2-41/files/rb02-amoled241-panel-cutout.dxf

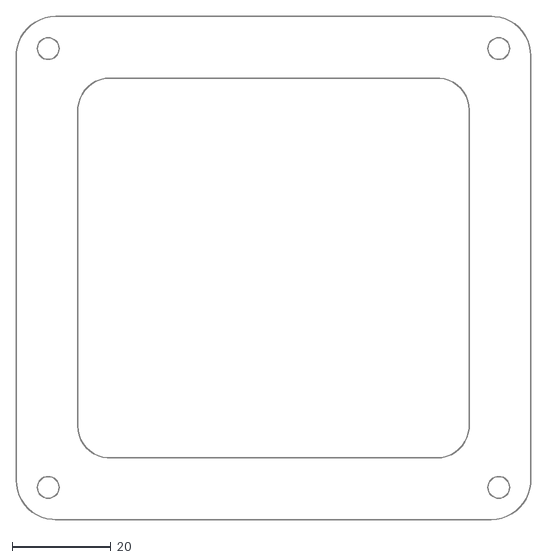
[picture p102: CAD file, 2026-11-01]
RB-02/printed-case-amoled-2-41/files/rb02-amoled241-panel-cutout.dxf
104.4 x 102.0
