xiaprojects/rb-cases/RB-02/round-case-amoled-1-75/files/rb02-amoled175-shell.stl

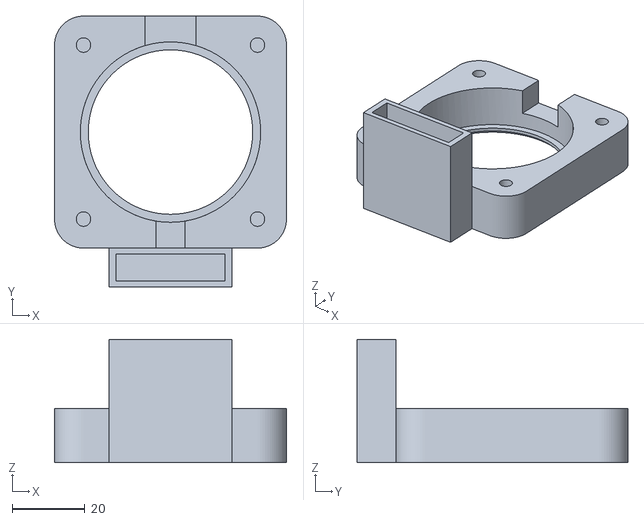
[picture p103: CAD file, 2026-11-01]
RB-02/round-case-amoled-1-75/files/rb02-amoled175-shell.stl
64.0 x 74.7 x 34.0
