xiaprojects/rb-cases/RB-02/sixpack-box-80mm-7088576/files/RB02B_Rear_GPS_-_2_Meshed.stl

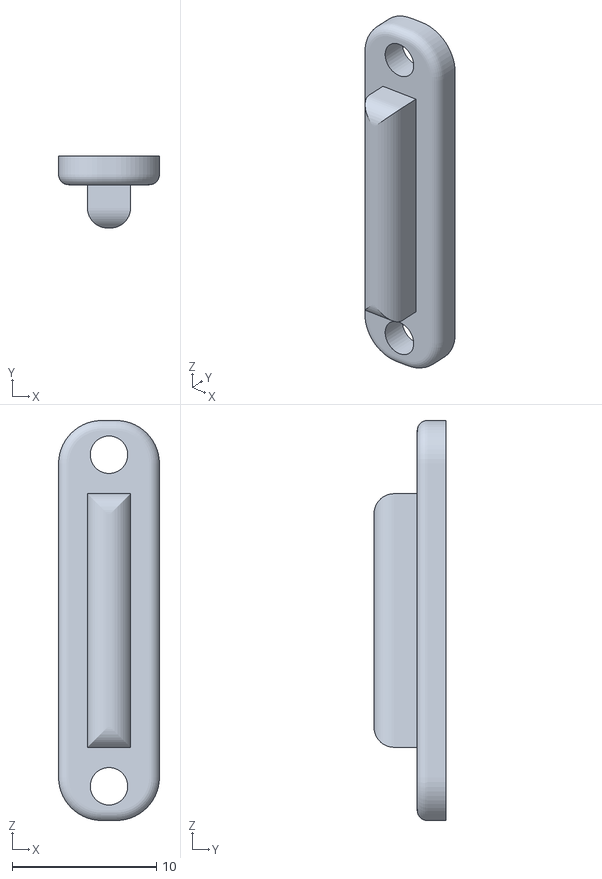
[picture p104: CAD file, 2026-10-31]
RB-02/sixpack-box-80mm-7088576/files/RB02B_Rear_GPS_-_2_Meshed.stl
7.00 x 5.00 x 27.7
