xiaprojects/rb-cases/RB-06/printed-case-waveshare-13-3-amoled/files/rb06-133amoled-case.FCStd

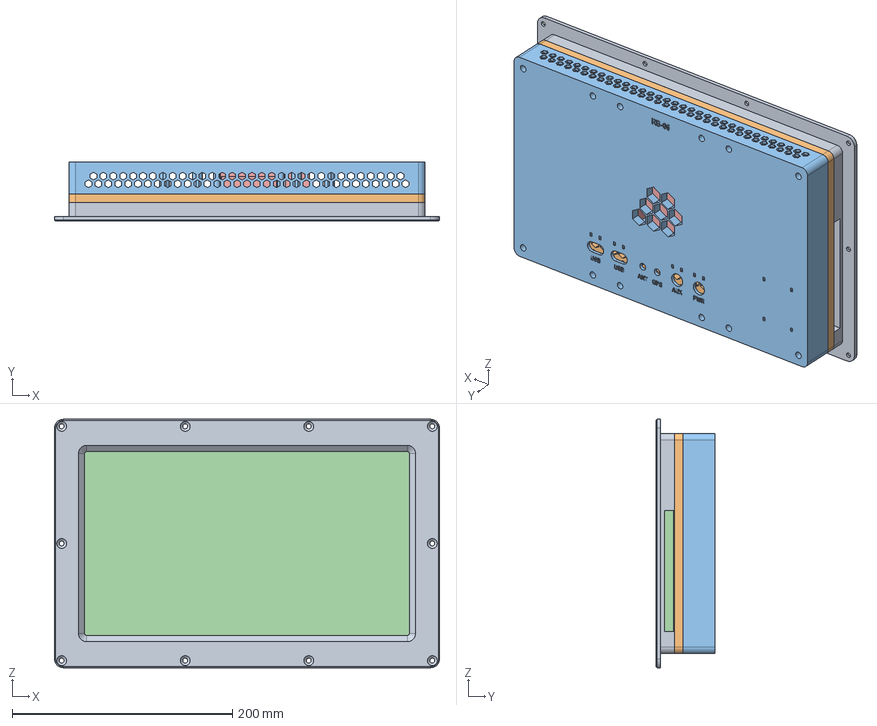
[picture p105: CAD file, 2026-11-01]
RB-06/printed-case-waveshare-13-3-amoled/files/rb06-133amoled-case.FCStd
349.8 x 54.0 x 225.8 mm
Bezel
Carrier
Rearcover
Display
RaspberryPi5
AHRS
