xiaprojects/rb-cases/RB-06/printed-case-waveshare-5-5-amoled/files/rb06-55amoled-case.FCStd

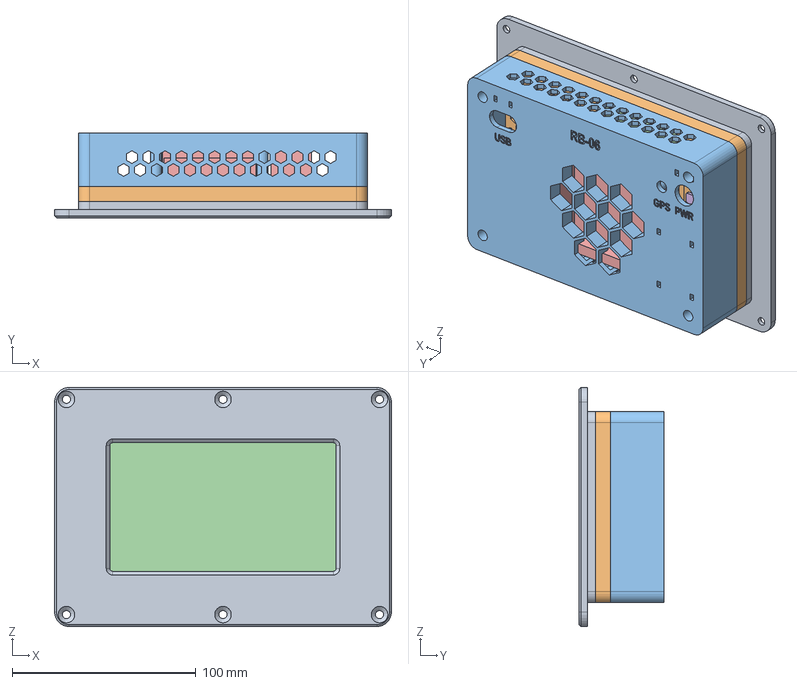
[picture p106: CAD file, 2026-11-01]
RB-06/printed-case-waveshare-5-5-amoled/files/rb06-55amoled-case.FCStd
183.2 x 46.0 x 130.0 mm
Bezel
Carrier
Rearcover
Display
RaspberryPi5
AHRS
