xiaprojects/rb-cases/RB-06/printed-case-waveshare-6-25/files/rb06-625-bezel.stl

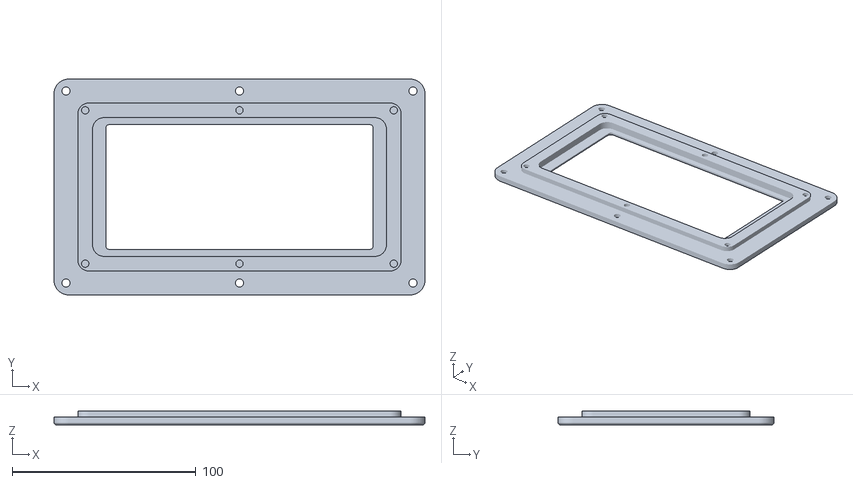
[picture p107: CAD file, 2026-11-01]
RB-06/printed-case-waveshare-6-25/files/rb06-625-bezel.stl
202.0 x 117.5 x 7.68
