xiaprojects/rb-cases/RB-06/printed-case-waveshare-7-9/files/rb06-79-panel-cutout.dxf

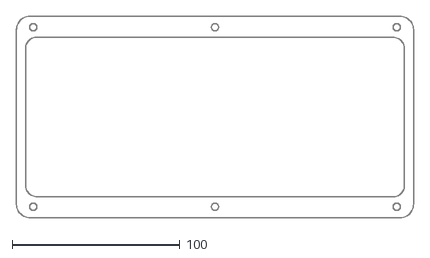
[picture p108: CAD file, 2026-11-01]
RB-06/printed-case-waveshare-7-9/files/rb06-79-panel-cutout.dxf
236.6 x 120.0
