xiaprojects/rb-cases/RB-06/printed-case-waveshare-70h/files/rb06-70h-carrier.stl

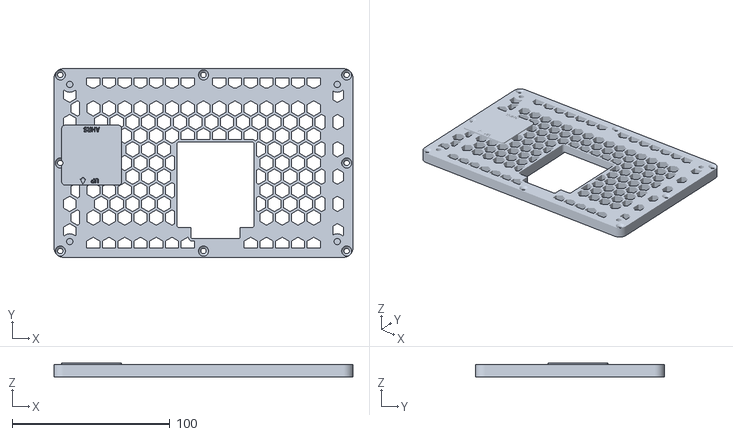
[picture p109: CAD file, 2026-11-01]
RB-06/printed-case-waveshare-70h/files/rb06-70h-carrier.stl
189.8 x 119.8 x 9.00
