xiaprojects/rb-cases/RB-06/printed-case-waveshare-7c/files/rb06-7c-rear-cover.stl

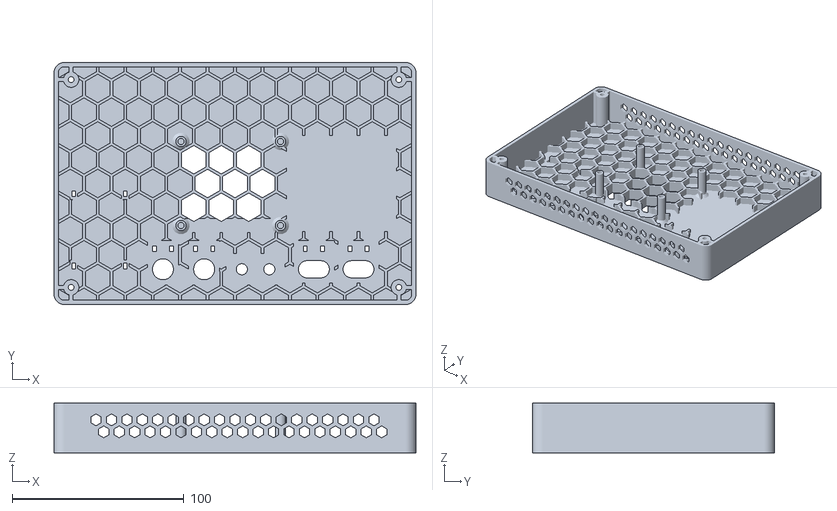
[picture p110: CAD file, 2026-11-01]
RB-06/printed-case-waveshare-7c/files/rb06-7c-rear-cover.stl
211.0 x 141.1 x 29.1
