xiaprojects/rb-cases/RB-Cockpits/desktop-pod/files/desktop-pod.FCStd

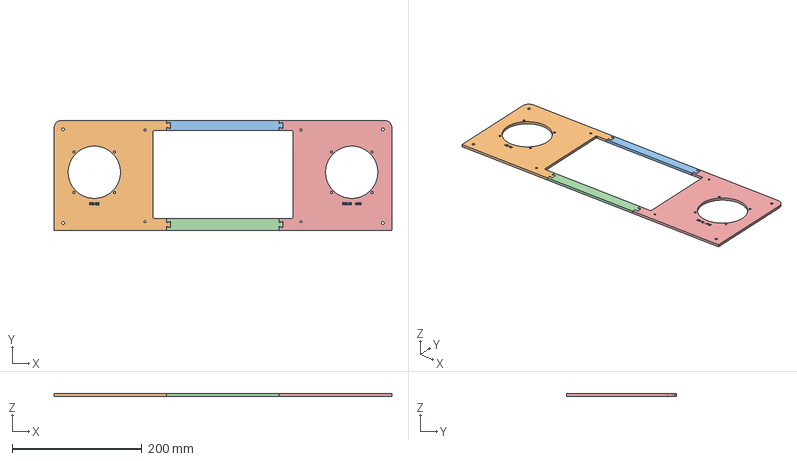
[picture p111: CAD file, 2026-10-31]
RB-Cockpits/desktop-pod/files/desktop-pod.FCStd
520.0 x 170.0 x 4.00 mm
Panel
Panel_A1
Panel_B1a
Panel_B1b
Panel_C1
