xiaprojects/rb-cases/RB-Cockpits/glass-cockpit-rig/files/glass-cockpit-rig-right-A2.stl

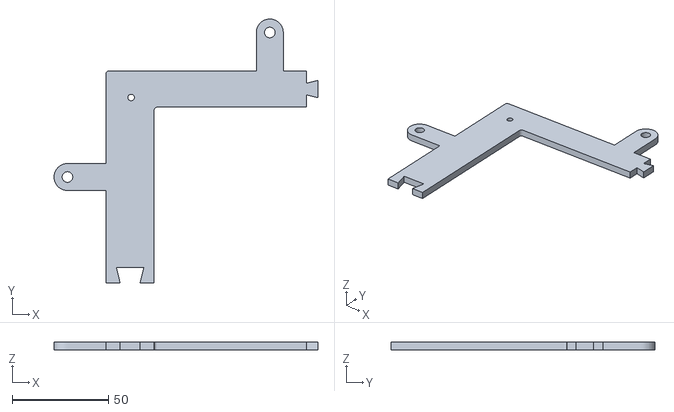
[picture p112: CAD file, 2026-10-31]
RB-Cockpits/glass-cockpit-rig/files/glass-cockpit-rig-right-A2.stl
137.0 x 137.0 x 4.00
