xiaprojects/rb-cases/RB-Cockpits/glider-panel/files/glider-panel-C1.stl

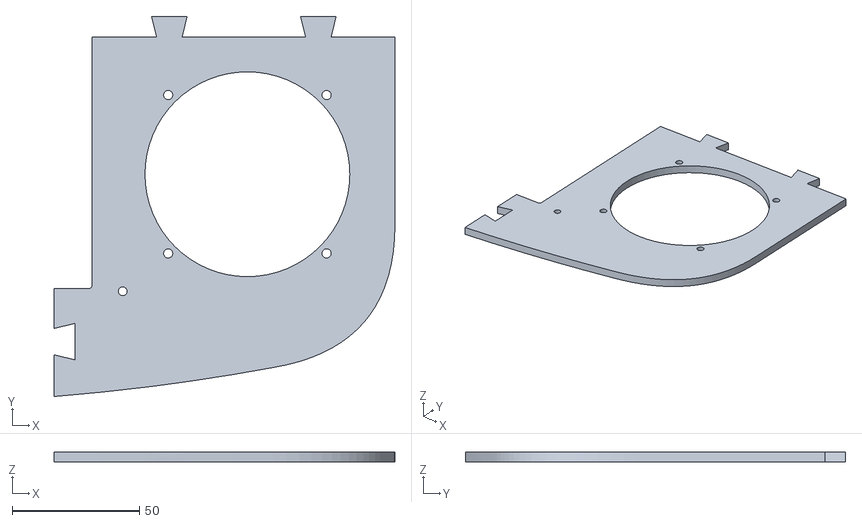
[picture p113: CAD file, 2026-10-31]
RB-Cockpits/glider-panel/files/glider-panel-C1.stl
134.0 x 149.4 x 4.00
