xiaprojects/rb-cases/RB-Cockpits/six-pack-trainer/files/six-pack-trainer-F2.stl

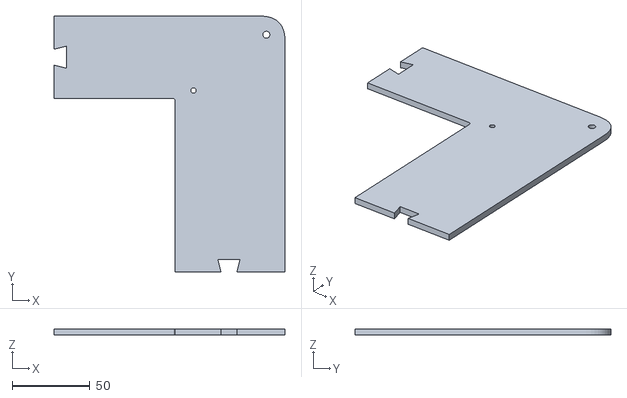
[picture p114: CAD file, 2026-10-31]
RB-Cockpits/six-pack-trainer/files/six-pack-trainer-F2.stl
149.0 x 165.0 x 4.00
