xiaprojects/rb-cases/RB-Cockpits/ultralight-rehearsal/files/ultralight-rehearsal-B2.stl

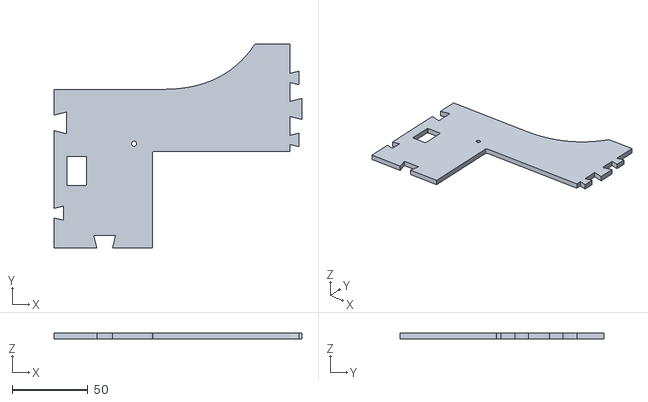
[picture p115: CAD file, 2026-10-31]
RB-Cockpits/ultralight-rehearsal/files/ultralight-rehearsal-B2.stl
164.0 x 135.0 x 4.00
