xiaprojects/rb-cases/RB-01/glasscockpit-8/files/rb01-glass-8-bezel.stl

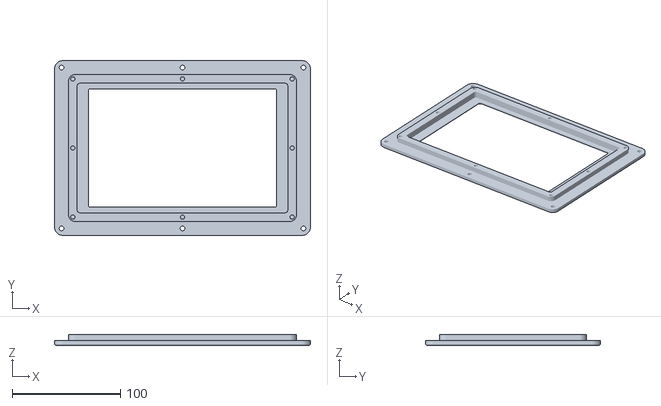
[picture p117: CAD file, 2026-11-01]
RB-01/glasscockpit-8/files/rb01-glass-8-bezel.stl
236.8 x 161.8 x 9.94
