xiaprojects/rb-cases/RB-01/glasscockpit-round/files/rb01-glass-round-shell.stl

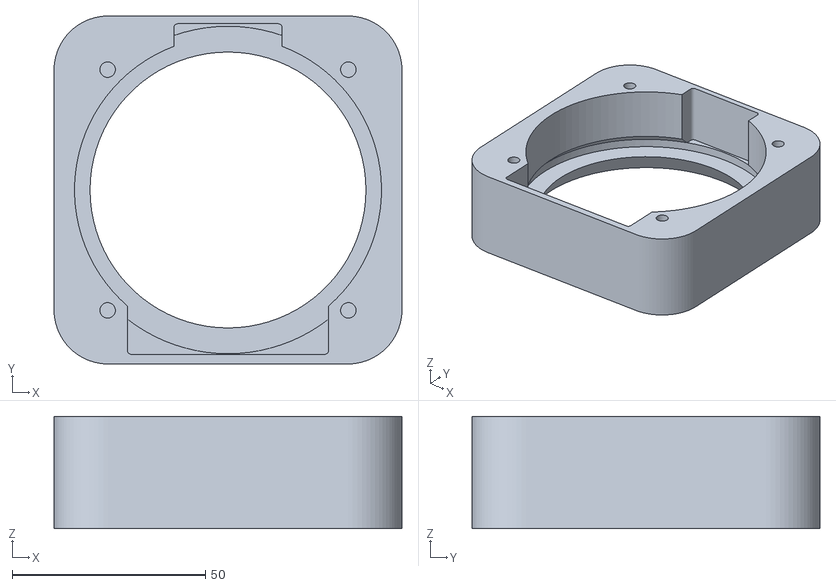
[picture p118: CAD file, 2026-11-07]
RB-01/glasscockpit-round/files/rb01-glass-round-shell.stl
90.0 x 90.0 x 29.0
