xiaprojects/rb-cases/RB-02/front-install-sixpack-box-80mm-7103368/files/RB02D_-_case_Meshed.stl

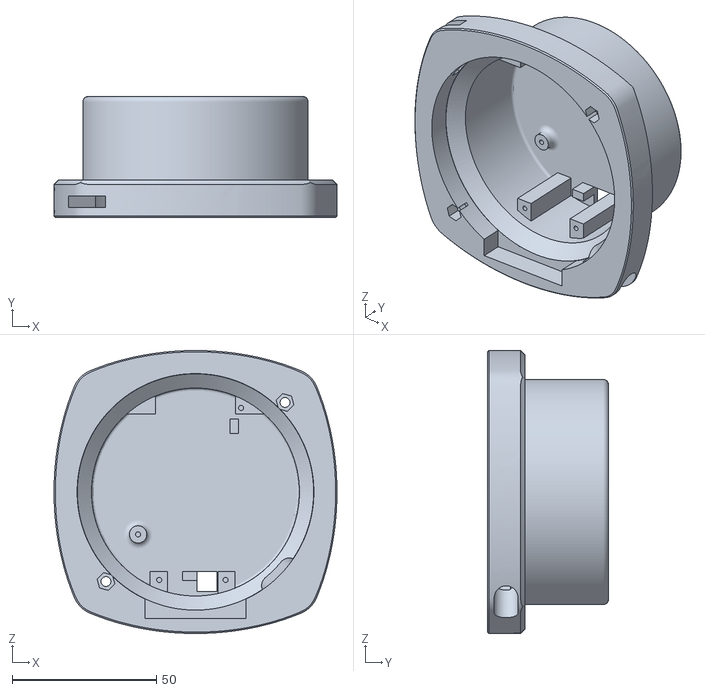
[picture p119: CAD file, 2026-10-31]
RB-02/front-install-sixpack-box-80mm-7103368/files/RB02D_-_case_Meshed.stl
98.0 x 42.0 x 98.0
