xiaprojects/rb-cases/RB-02/round-case-amoled-1-75/files/rb02-amoled175-case.FCStd

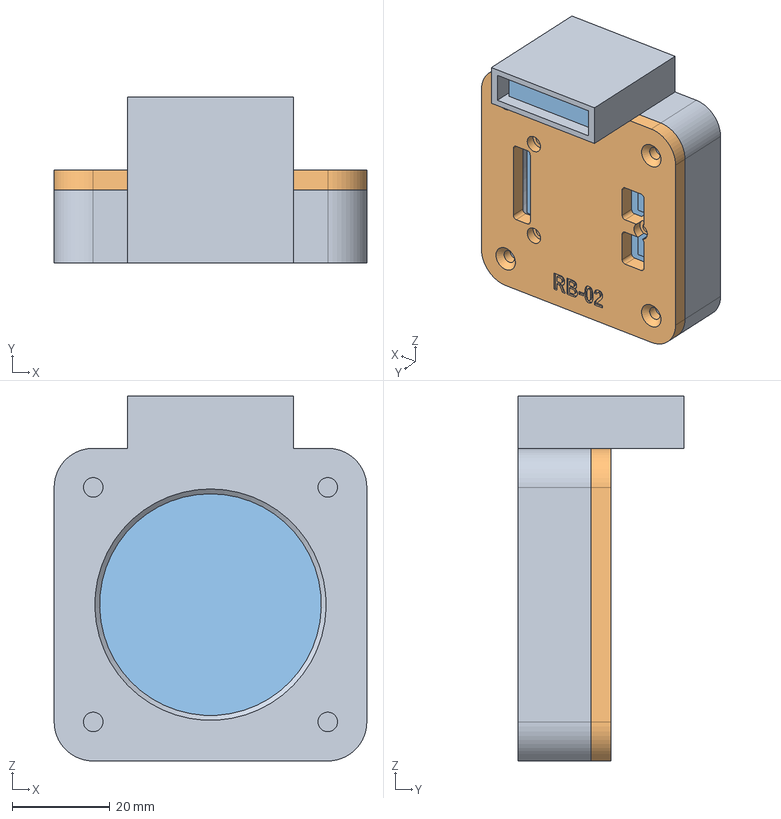
[picture p121: CAD file, 2026-11-01]
RB-02/round-case-amoled-1-75/files/rb02-amoled175-case.FCStd
64.0 x 34.0 x 74.7 mm
Cap
Display
