xiaprojects/rb-cases/RB-02/sixpack-box-80mm-7088576/files/RB02B_Rear_Meshed.stl

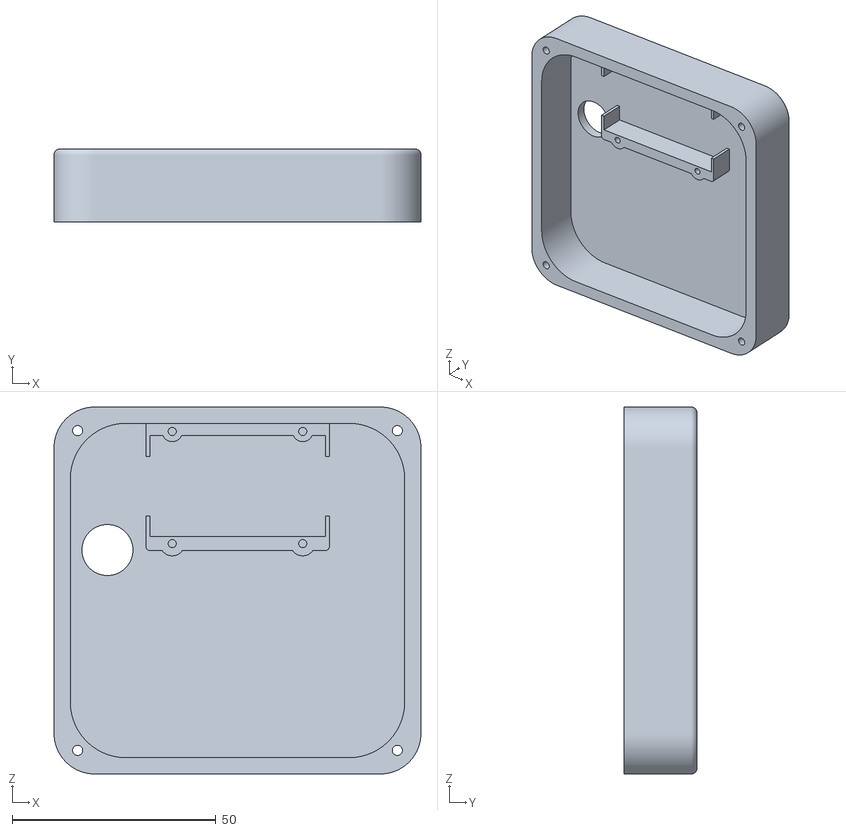
[picture p122: CAD file, 2026-10-31]
RB-02/sixpack-box-80mm-7088576/files/RB02B_Rear_Meshed.stl
90.0 x 18.0 x 90.0
