xiaprojects/rb-cases/RB-06/printed-case-waveshare-13-3-amoled/files/rb06-133amoled-carrier-right.stl

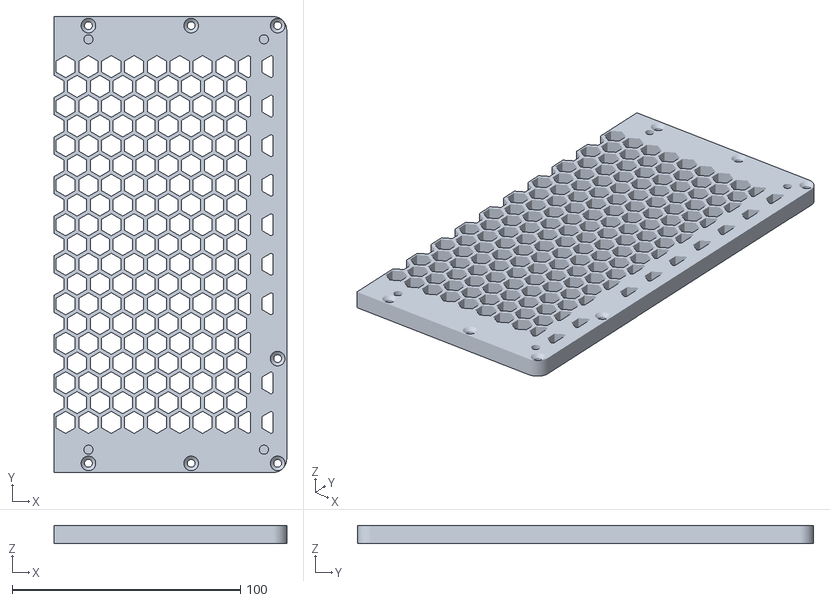
[picture p123: CAD file, 2026-11-01]
RB-06/printed-case-waveshare-13-3-amoled/files/rb06-133amoled-carrier-right.stl
101.9 x 199.8 x 8.00
