xiaprojects/rb-cases/RB-06/printed-case-waveshare-5-5-amoled/files/rb06-55amoled-bezel.stl

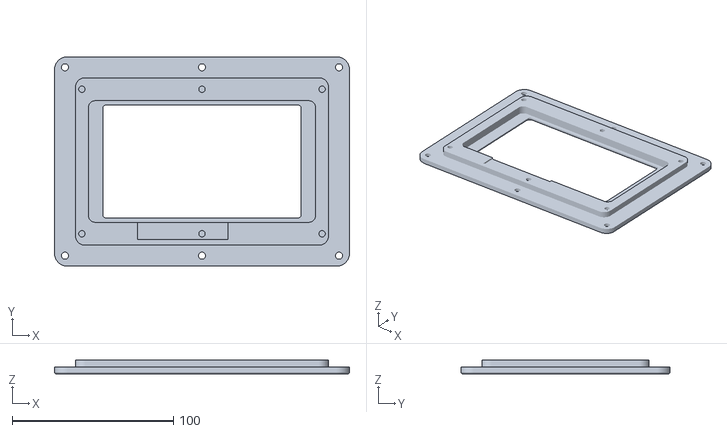
[picture p124: CAD file, 2026-11-01]
RB-06/printed-case-waveshare-5-5-amoled/files/rb06-55amoled-bezel.stl
183.2 x 130.0 x 8.90
