xiaprojects/rb-cases/RB-06/printed-case-waveshare-6-25/files/rb06-625-carrier.stl

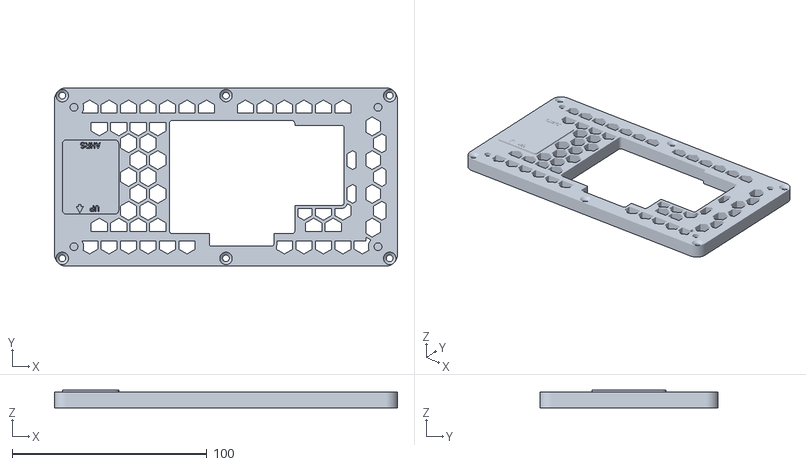
[picture p125: CAD file, 2026-11-01]
RB-06/printed-case-waveshare-6-25/files/rb06-625-carrier.stl
176.0 x 91.5 x 9.00
