xiaprojects/rb-cases/RB-06/printed-case-waveshare-7-9/files/rb06-79-case.FCStd

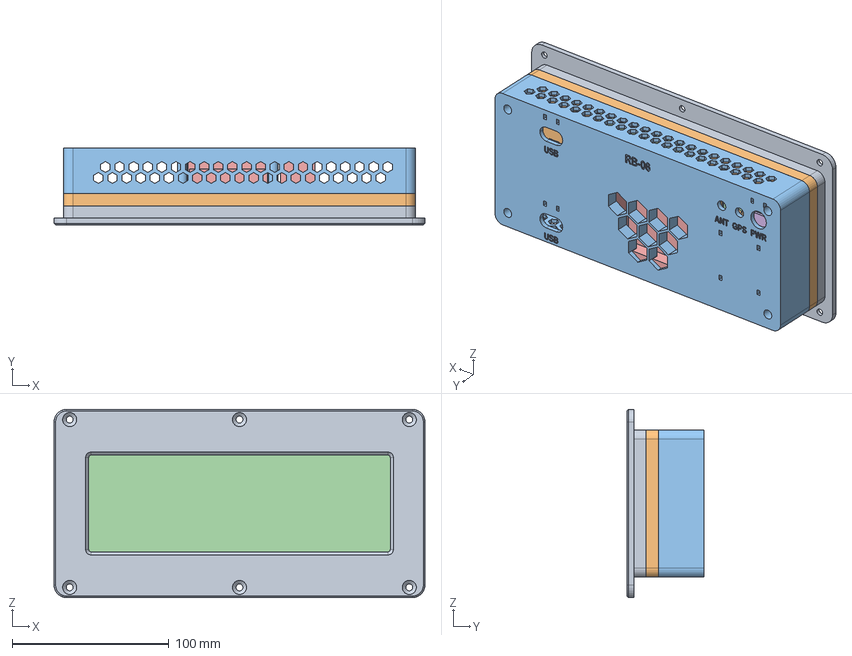
[picture p126: CAD file, 2026-11-01]
RB-06/printed-case-waveshare-7-9/files/rb06-79-case.FCStd
236.6 x 49.1 x 120.0 mm
Bezel
Carrier
Rearcover
Display
RaspberryPi5
AHRS
