xiaprojects/rb-cases/RB-06/printed-case-waveshare-70h/files/rb06-70h-case.FCStd

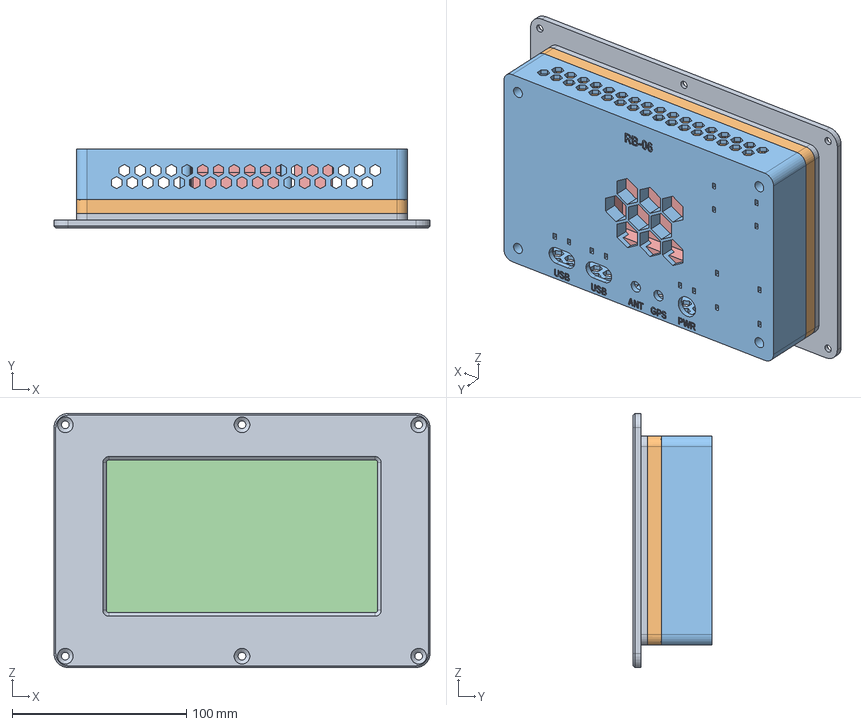
[picture p127: CAD file, 2026-11-01]
RB-06/printed-case-waveshare-70h/files/rb06-70h-case.FCStd
215.8 x 45.3 x 145.8 mm
Bezel
Carrier
Rearcover
Display
RaspberryPi5
AHRS
