xiaprojects/rb-cases/RB-06/printed-case-waveshare-7c/files/rb06-7c-panel-cutout.dxf

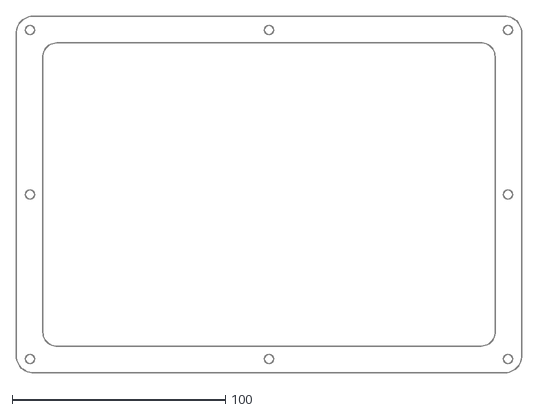
[picture p128: CAD file, 2026-11-01]
RB-06/printed-case-waveshare-7c/files/rb06-7c-panel-cutout.dxf
237.0 x 167.1
