xiaprojects/rb-cases/RB-Cockpits/desktop-pod/files/desktop-pod-B1a.stl

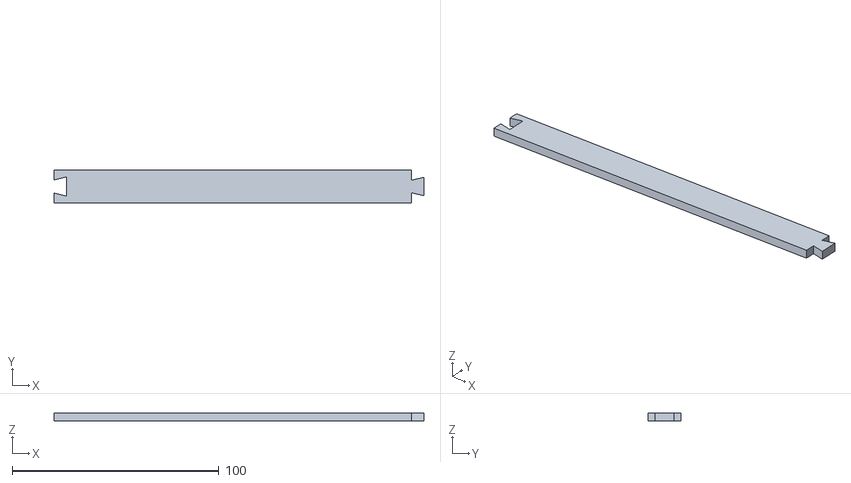
[picture p129: CAD file, 2026-10-31]
RB-Cockpits/desktop-pod/files/desktop-pod-B1a.stl
179.0 x 16.0 x 4.00
