xiaprojects/rb-cases/RB-Cockpits/glass-cockpit-rig/files/glass-cockpit-rig-centre.dxf

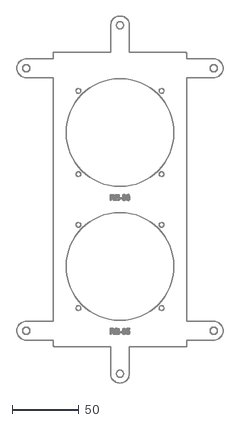
[picture p130: CAD file, 2026-10-31]
RB-Cockpits/glass-cockpit-rig/files/glass-cockpit-rig-centre.dxf
154.0 x 274.0
