xiaprojects/rb-cases/RB-Cockpits/glider-panel/files/glider-panel.FCStd

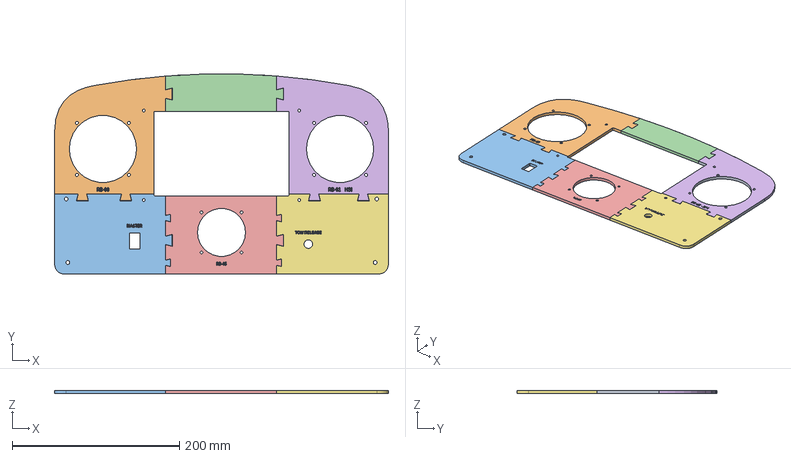
[picture p131: CAD file, 2026-10-31]
RB-Cockpits/glider-panel/files/glider-panel.FCStd
400.0 x 240.0 x 4.00 mm
Panel
Panel_A1
Panel_A2
Panel_B1
Panel_B2
Panel_C1
Panel_C2
