xiaprojects/rb-cases/RB-Cockpits/six-pack-trainer/files/six-pack-trainer-C3.stl

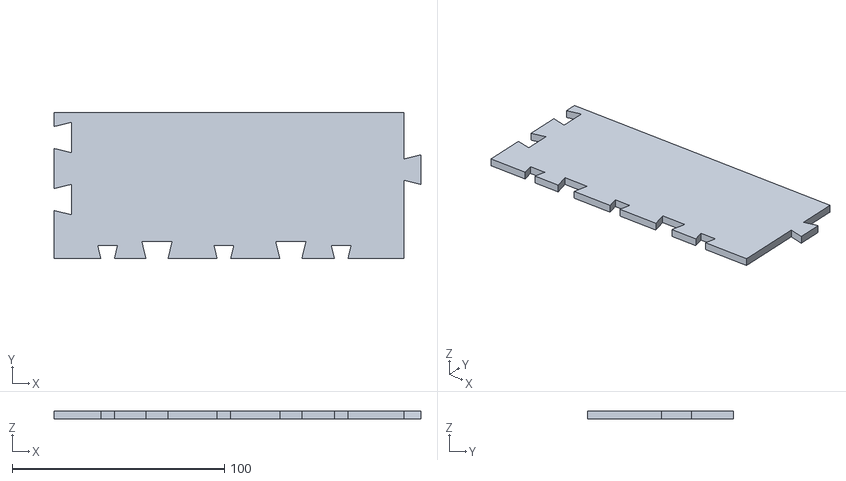
[picture p132: CAD file, 2026-10-31]
RB-Cockpits/six-pack-trainer/files/six-pack-trainer-C3.stl
173.0 x 69.0 x 4.00
