xiaprojects/rb-cases/RB-Cockpits/ultralight-rehearsal/files/ultralight-rehearsal-B1.stl

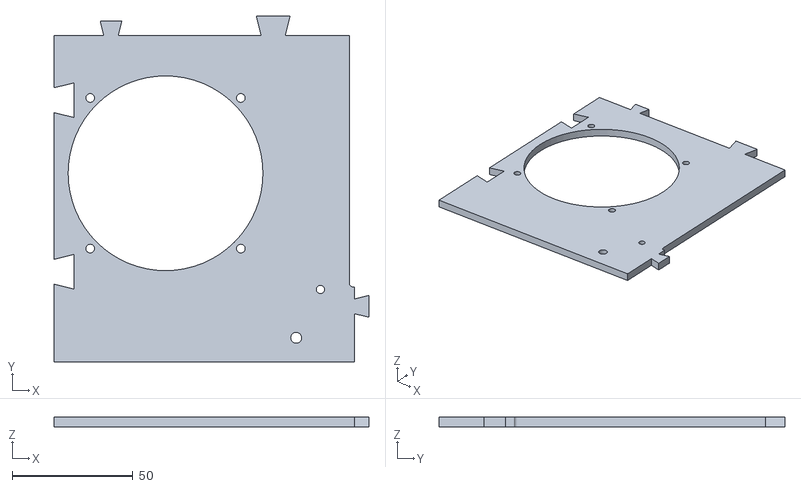
[picture p133: CAD file, 2026-10-31]
RB-Cockpits/ultralight-rehearsal/files/ultralight-rehearsal-B1.stl
130.0 x 143.0 x 4.00
