xiaprojects/rb-cases/RB-01/3d-synthview-7162277/files/RB01.05_-_Foratura_Meshed.stl

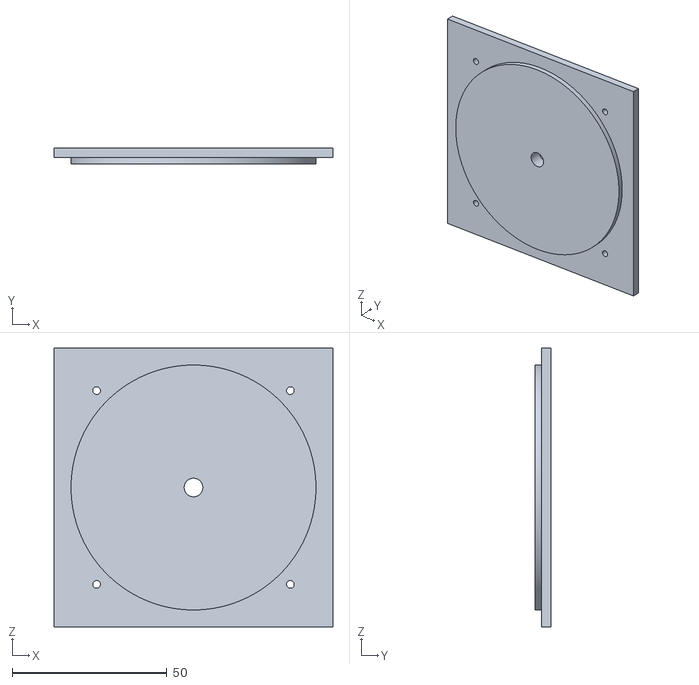
[picture p134: CAD file, 2026-10-31]
RB-01/3d-synthview-7162277/files/RB01.05_-_Foratura_Meshed.stl
90.0 x 5.00 x 90.0
