xiaprojects/rb-cases/RB-01/glasscockpit-8/files/rb01-glass-8-panel-cutout.dxf

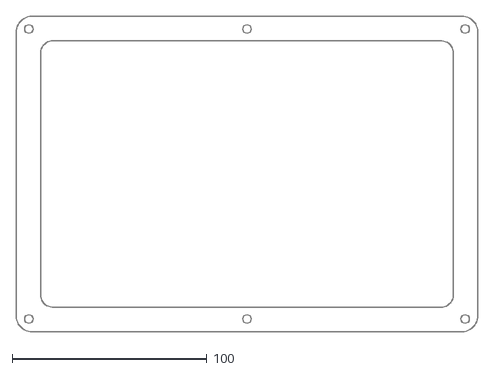
[picture p135: CAD file, 2026-11-01]
RB-01/glasscockpit-8/files/rb01-glass-8-panel-cutout.dxf
236.8 x 161.8
