xiaprojects/rb-cases/RB-02/front-install-sixpack-box-80mm-7103368/files/RB02C_-_power_lock_Meshed.stl

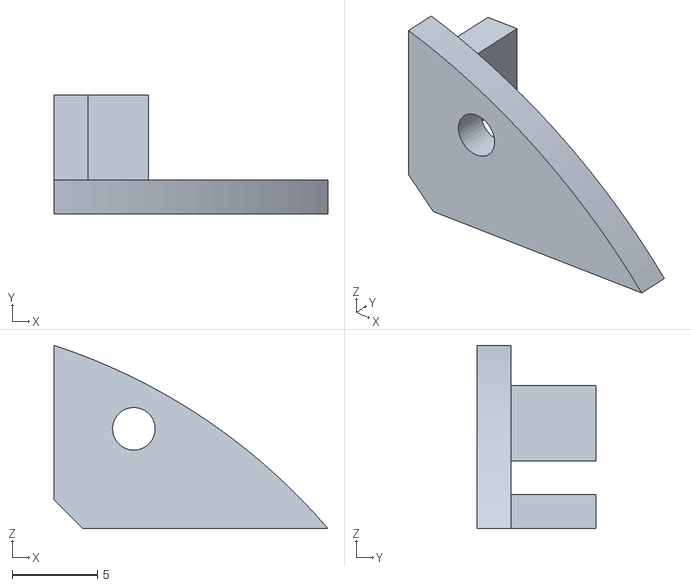
[picture p136: CAD file, 2026-10-31]
RB-02/front-install-sixpack-box-80mm-7103368/files/RB02C_-_power_lock_Meshed.stl
16.1 x 7.00 x 10.8
