xiaprojects/rb-cases/RB-02/printed-case-amoled-2-41/files/rb02-amoled241-bezel.stl

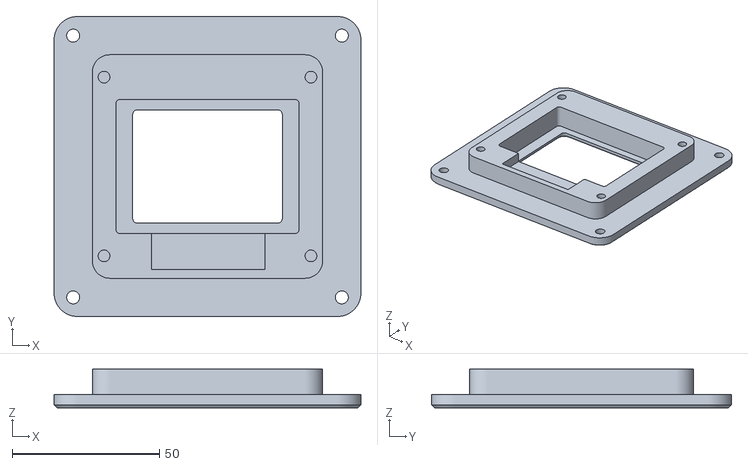
[picture p137: CAD file, 2026-11-01]
RB-02/printed-case-amoled-2-41/files/rb02-amoled241-bezel.stl
104.4 x 102.0 x 13.1
