xiaprojects/rb-cases/RB-02/sixpack-box-80mm-7088576/files/RB2B_Monitor_Template_Meshed.stl

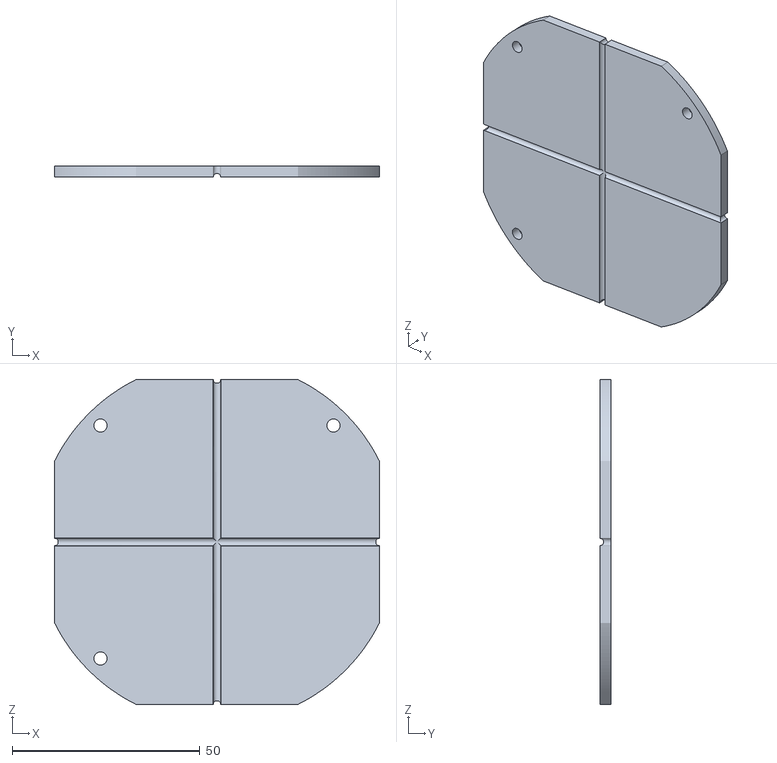
[picture p138: CAD file, 2026-10-31]
RB-02/sixpack-box-80mm-7088576/files/RB2B_Monitor_Template_Meshed.stl
86.5 x 3.00 x 86.5
