xiaprojects/rb-cases/RB-06/printed-case-waveshare-13-3-amoled/files/rb06-133amoled-rear-cover-left.stl

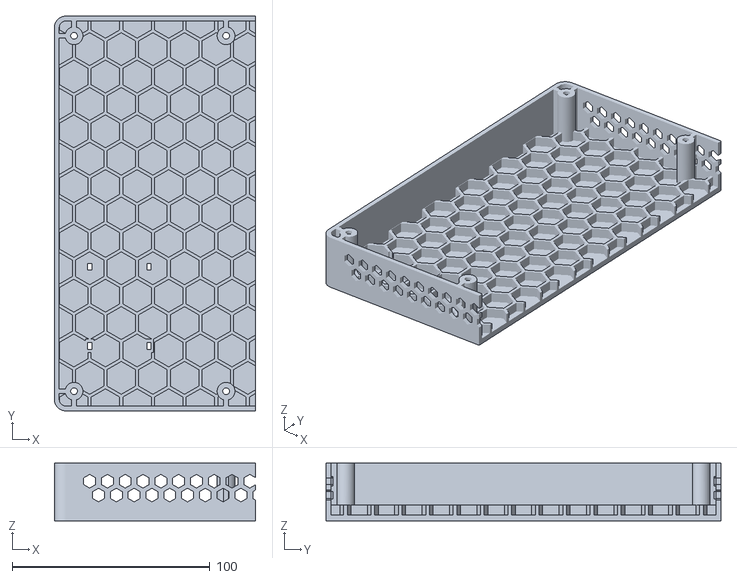
[picture p139: CAD file, 2026-11-01]
RB-06/printed-case-waveshare-13-3-amoled/files/rb06-133amoled-rear-cover-left.stl
101.9 x 199.8 x 29.1
