xiaprojects/rb-cases/RB-06/printed-case-waveshare-5-5-amoled/files/rb06-55amoled-carrier.stl

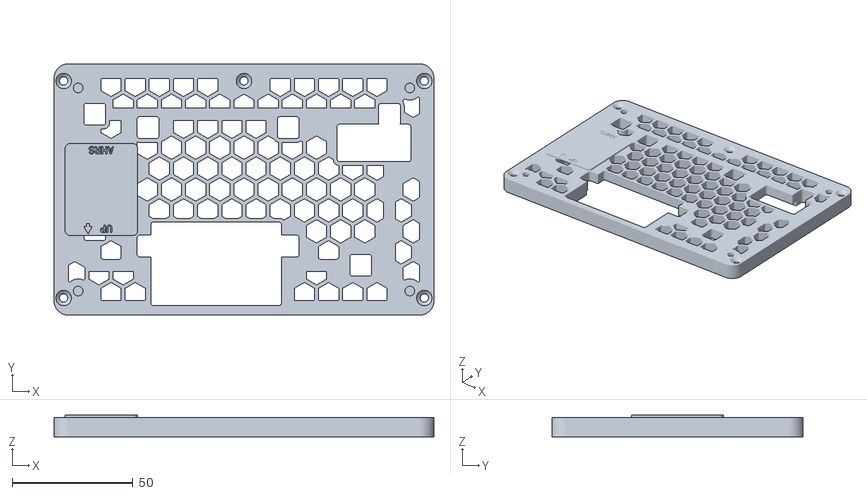
[picture p140: CAD file, 2026-11-01]
RB-06/printed-case-waveshare-5-5-amoled/files/rb06-55amoled-carrier.stl
157.2 x 104.0 x 9.00
