xiaprojects/rb-cases/RB-06/printed-case-waveshare-6-25/files/rb06-625-panel-cutout.dxf

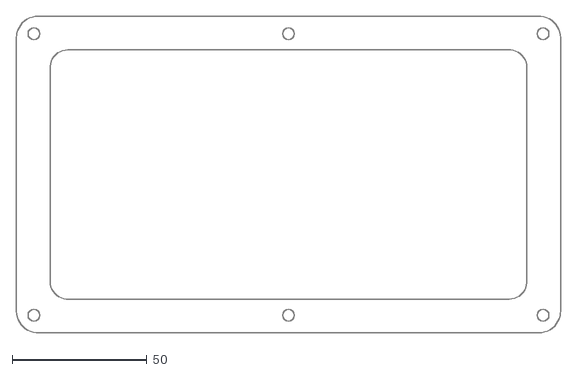
[picture p141: CAD file, 2026-11-01]
RB-06/printed-case-waveshare-6-25/files/rb06-625-panel-cutout.dxf
202.0 x 117.5
