xiaprojects/rb-cases/RB-06/printed-case-waveshare-7-9/files/rb06-79-bezel.stl

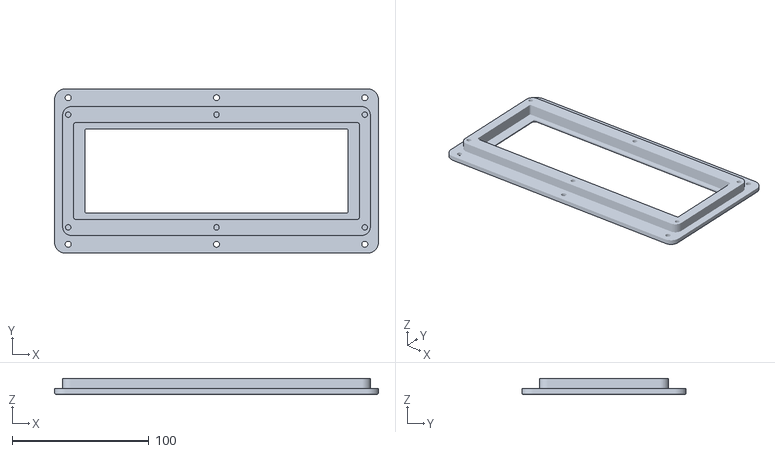
[picture p142: CAD file, 2026-11-01]
RB-06/printed-case-waveshare-7-9/files/rb06-79-bezel.stl
236.6 x 120.0 x 12.0
