xiaprojects/rb-cases/RB-06/printed-case-waveshare-70h/files/rb06-70h-bezel.stl

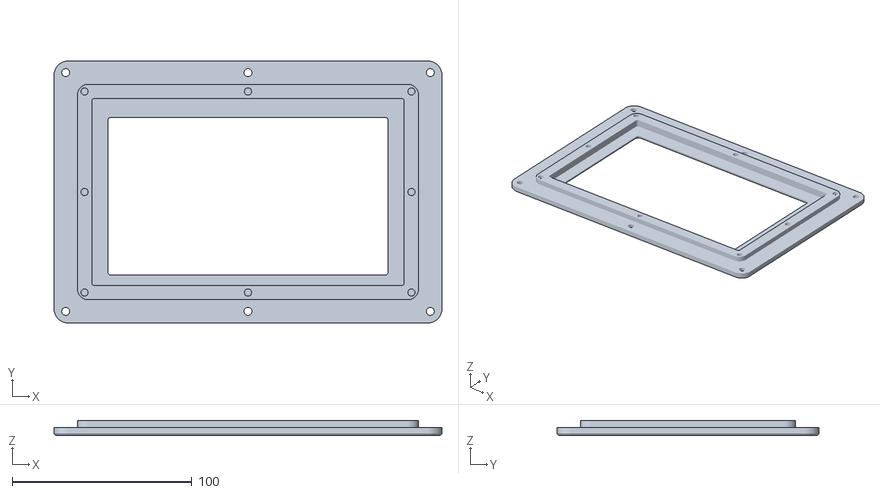
[picture p143: CAD file, 2026-11-01]
RB-06/printed-case-waveshare-70h/files/rb06-70h-bezel.stl
215.8 x 145.8 x 8.20
