xiaprojects/rb-cases/RB-06/printed-case-waveshare-7c/files/rb06-7c-case.FCStd

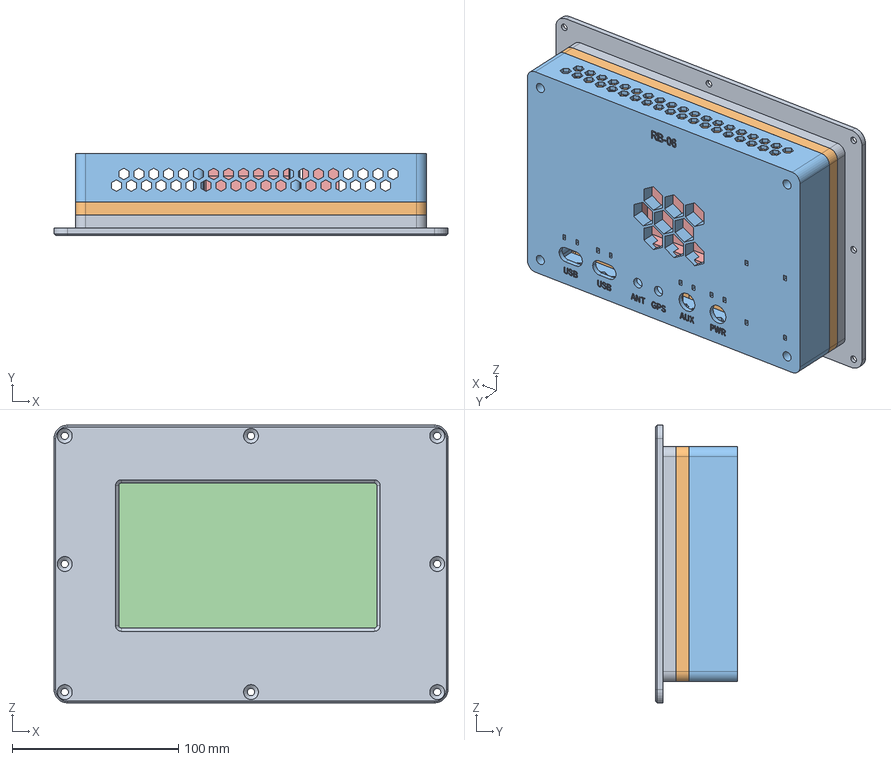
[picture p144: CAD file, 2026-11-01]
RB-06/printed-case-waveshare-7c/files/rb06-7c-case.FCStd
237.0 x 49.3 x 167.1 mm
Bezel
Carrier
Rearcover
Display
RaspberryPi5
AHRS
