xiaprojects/rb-cases/RB-Cockpits/desktop-pod/files/desktop-pod-B1b.stl

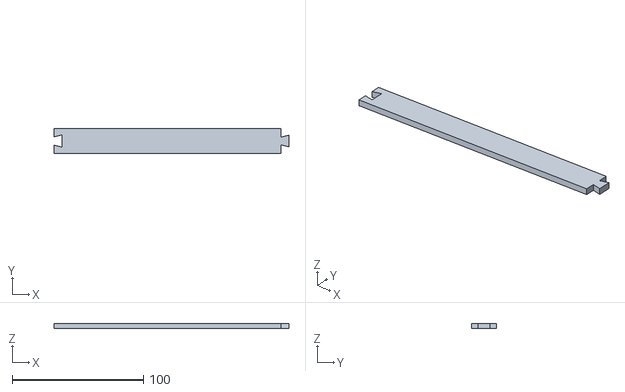
[picture p145: CAD file, 2026-10-31]
RB-Cockpits/desktop-pod/files/desktop-pod-B1b.stl
179.0 x 19.0 x 4.00
