xiaprojects/rb-cases/RB-Cockpits/glass-cockpit-rig/files/glass-cockpit-rig-right-A1.stl

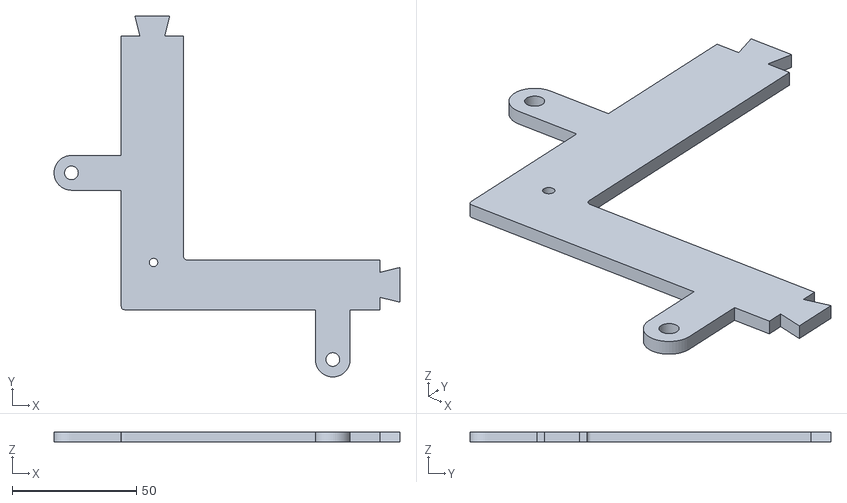
[picture p146: CAD file, 2026-10-31]
RB-Cockpits/glass-cockpit-rig/files/glass-cockpit-rig-right-A1.stl
139.0 x 145.0 x 4.00
