xiaprojects/rb-cases/RB-Cockpits/glider-panel/files/glider-panel-B1.stl

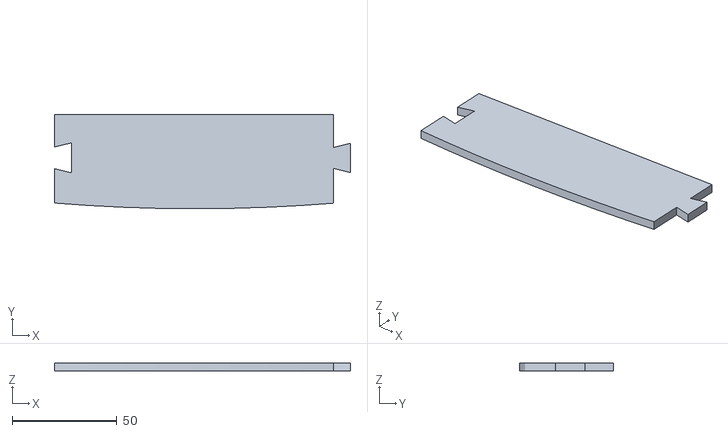
[picture p147: CAD file, 2026-10-31]
RB-Cockpits/glider-panel/files/glider-panel-B1.stl
141.0 x 45.0 x 4.00
