xiaprojects/rb-cases/RB-Cockpits/ultralight-rehearsal/files/ultralight-rehearsal-D1.stl

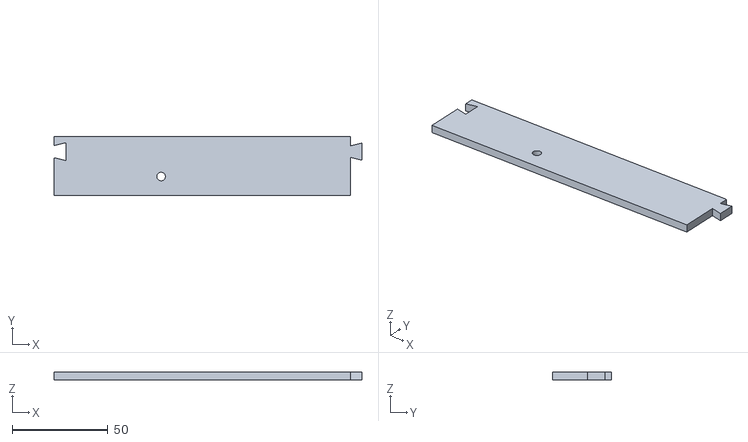
[picture p149: CAD file, 2026-10-31]
RB-Cockpits/ultralight-rehearsal/files/ultralight-rehearsal-D1.stl
161.0 x 31.0 x 4.00
