xiaprojects/rb-cases/RB-01/3d-synthview-7162277/files/RB01.05_-_Base_A_Meshed.stl

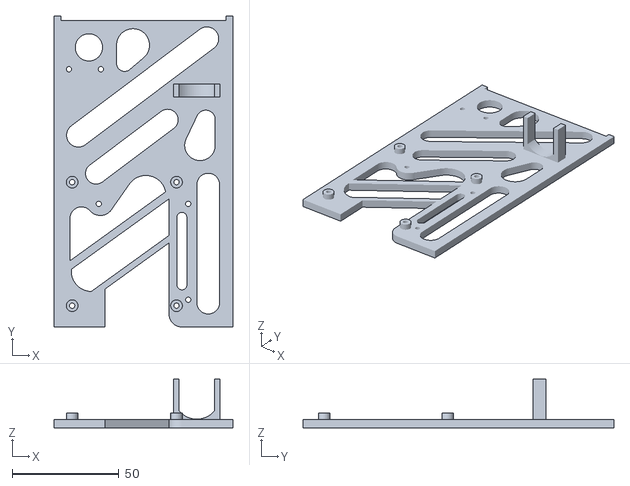
[picture p150: CAD file, 2026-10-31]
RB-01/3d-synthview-7162277/files/RB01.05_-_Base_A_Meshed.stl
84.0 x 146.0 x 23.0
