xiaprojects/rb-cases/RB-02/front-install-sixpack-box-80mm-7103368/files/RB02D_-_front_panel_Meshed.stl

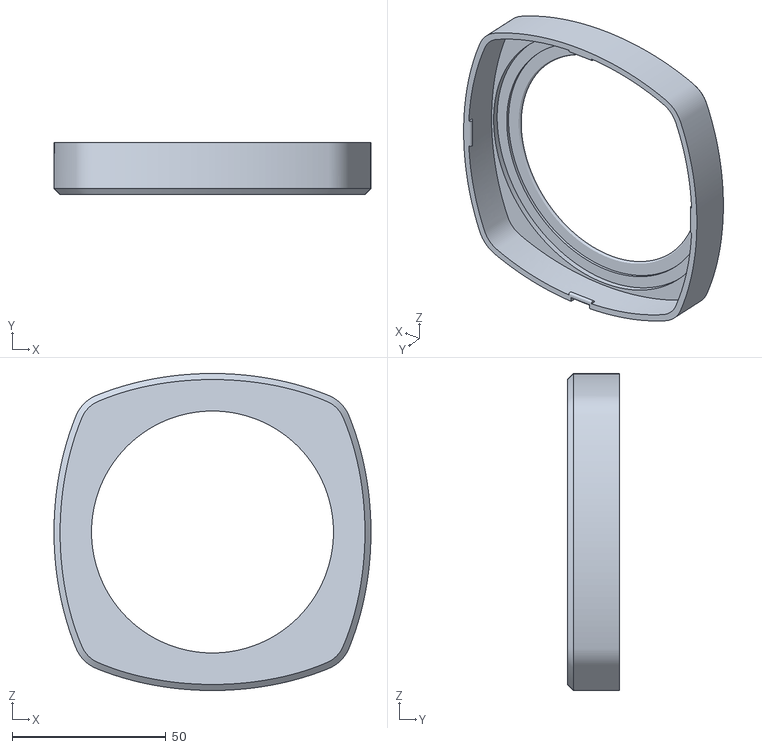
[picture p151: CAD file, 2026-10-31]
RB-02/front-install-sixpack-box-80mm-7103368/files/RB02D_-_front_panel_Meshed.stl
103.0 x 17.0 x 103.0
