xiaprojects/rb-cases/RB-02/sixpack-box-80mm-7088576/files/RB02B_Rear_GPS_Meshed.stl

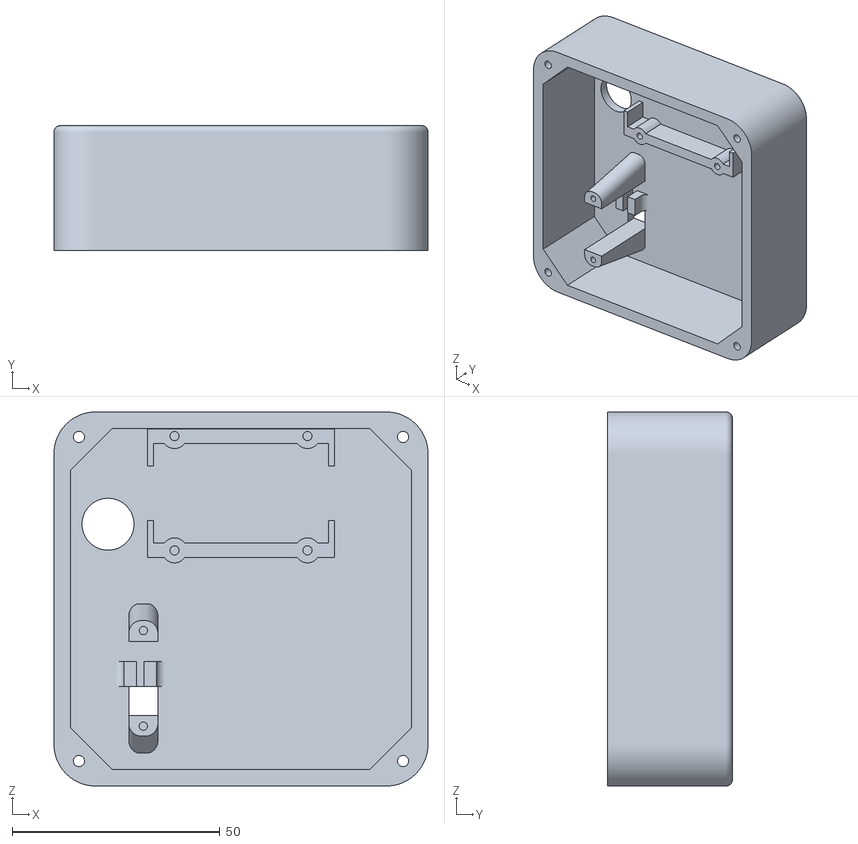
[picture p152: CAD file, 2026-10-31]
RB-02/sixpack-box-80mm-7088576/files/RB02B_Rear_GPS_Meshed.stl
90.0 x 30.0 x 90.0
