xiaprojects/rb-cases/RB-Cockpits/glider-panel/files/glider-panel-A2.stl

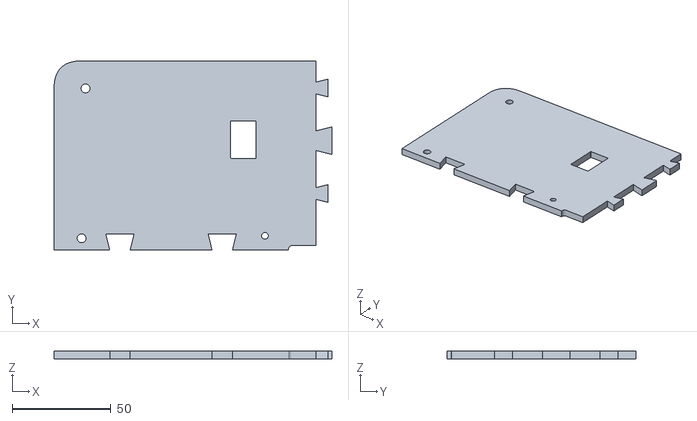
[picture p154: CAD file, 2026-10-31]
RB-Cockpits/glider-panel/files/glider-panel-A2.stl
141.0 x 96.0 x 4.00
