xiaprojects/rb-cases/RB-Cockpits/six-pack-trainer/files/six-pack-trainer-A1.stl

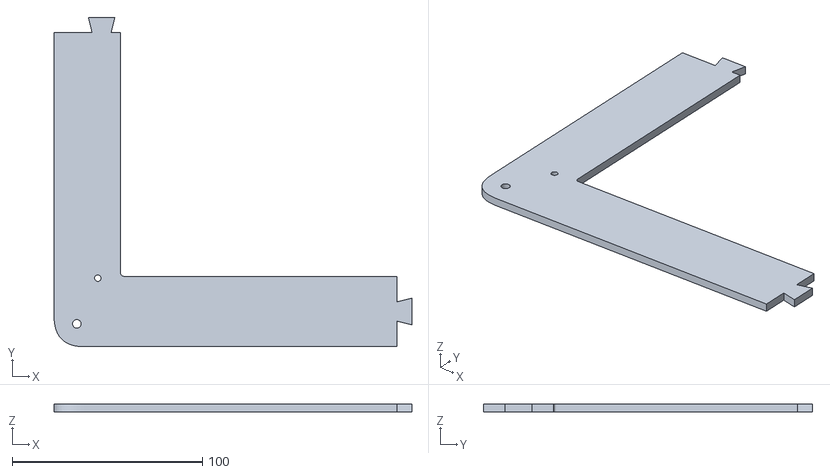
[picture p155: CAD file, 2026-10-31]
RB-Cockpits/six-pack-trainer/files/six-pack-trainer-A1.stl
188.0 x 173.0 x 4.00
