xiaprojects/rb-cases/RB-01/3d-synthview-7162277/files/RB01.05_-_Ghiera_Meshed.stl

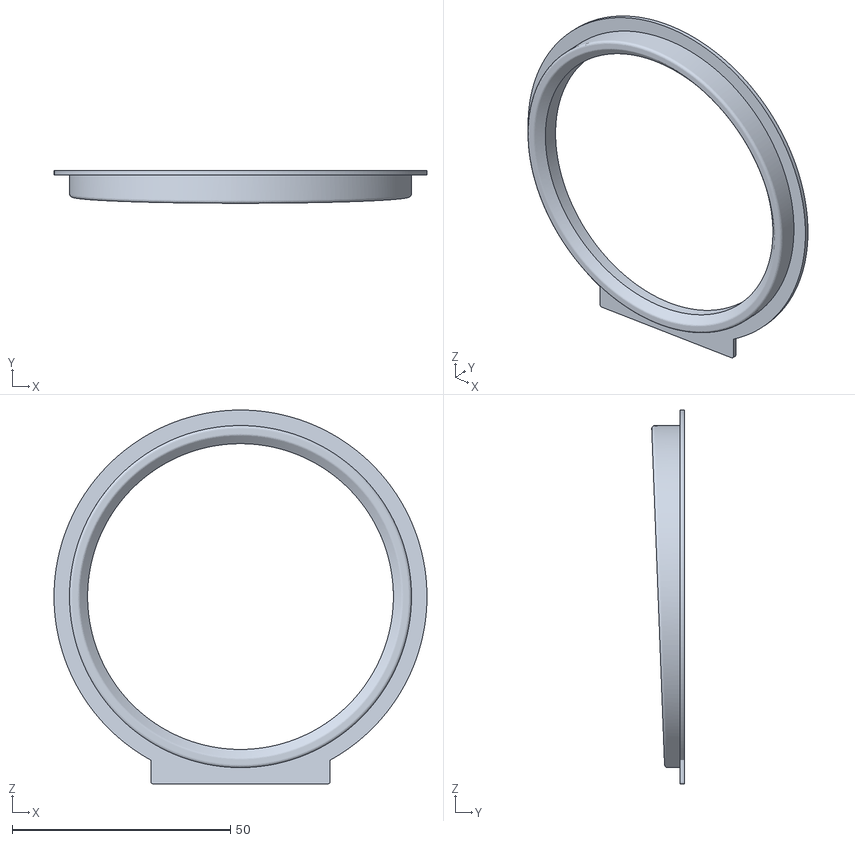
[picture p156: CAD file, 2026-10-31]
RB-01/3d-synthview-7162277/files/RB01.05_-_Ghiera_Meshed.stl
85.4 x 7.46 x 85.6
