xiaprojects/rb-cases/RB-02/sixpack-box-80mm-7088576/files/RB2B_Ring_Meshed.stl

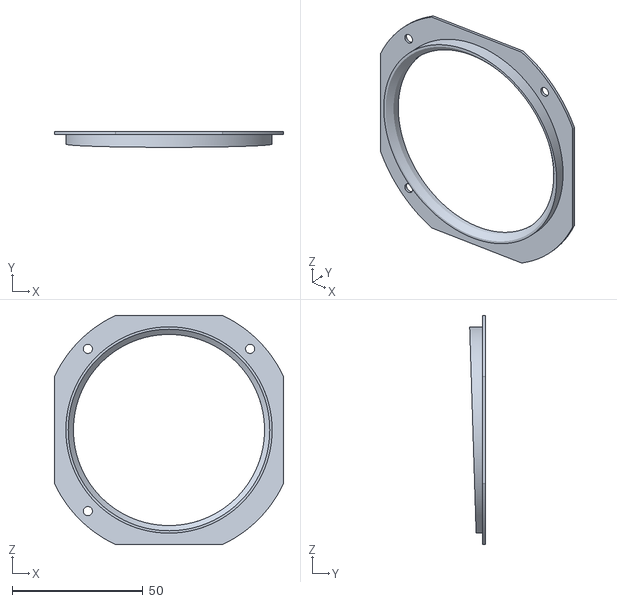
[picture p157: CAD file, 2026-10-31]
RB-02/sixpack-box-80mm-7088576/files/RB2B_Ring_Meshed.stl
87.5 x 5.99 x 87.5
