xiaprojects/rb-cases/RB-Cockpits/glass-cockpit-rig/files/glass-cockpit-rig-left-C1.stl

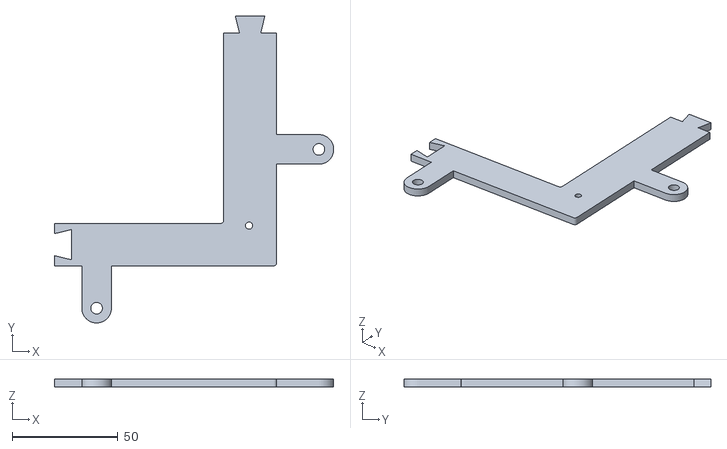
[picture p159: CAD file, 2026-10-31]
RB-Cockpits/glass-cockpit-rig/files/glass-cockpit-rig-left-C1.stl
132.0 x 145.0 x 4.00
