xiaprojects/rb-cases/RB-Cockpits/glider-panel/files/glider-panel-C2.stl

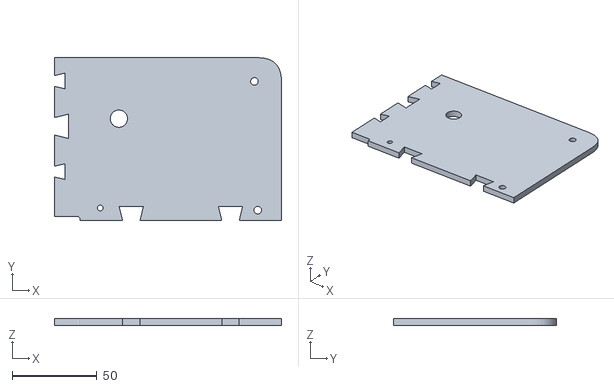
[picture p160: CAD file, 2026-10-31]
RB-Cockpits/glider-panel/files/glider-panel-C2.stl
134.0 x 96.0 x 4.00
