xiaprojects/rb-cases/RB-01/3d-synthview-7162277/files/RB01.05_-_Sfiato_Meshed.stl

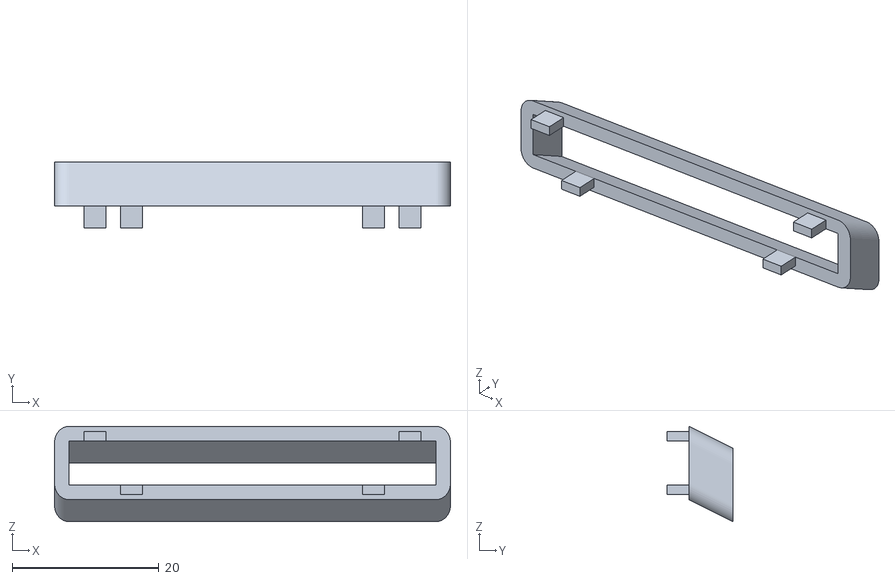
[picture p163: CAD file, 2026-10-31]
RB-01/3d-synthview-7162277/files/RB01.05_-_Sfiato_Meshed.stl
54.0 x 9.00 x 13.0
