xiaprojects/rb-cases/RB-Cockpits/six-pack-trainer/files/six-pack-trainer-B1.stl

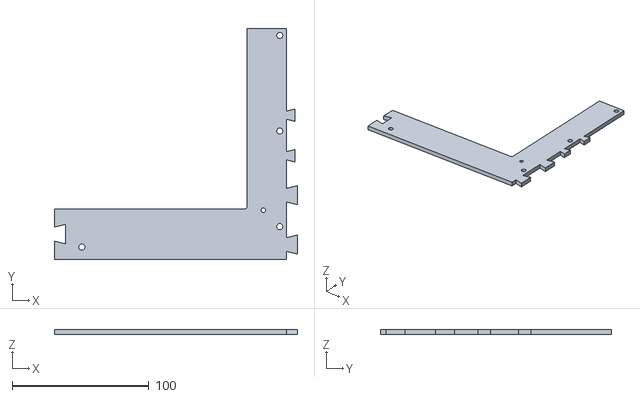
[picture p166: CAD file, 2026-10-31]
RB-Cockpits/six-pack-trainer/files/six-pack-trainer-B1.stl
178.0 x 169.0 x 4.00
