xiaprojects/rb-cases/RB-01/3d-synthview-7162277/files/RB01.05_-_Distanziali_Base_Meshed.stl

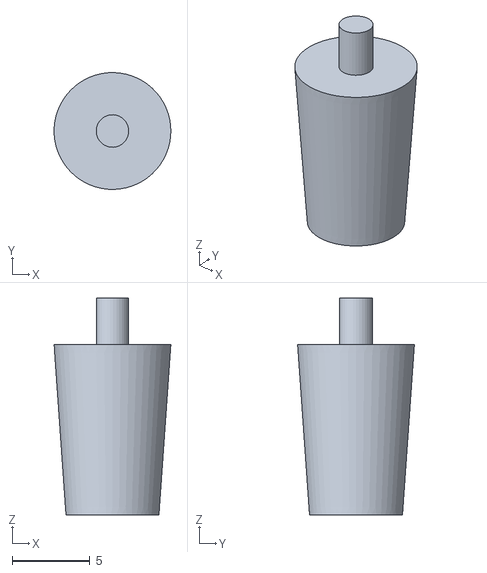
[picture p168: CAD file, 2026-10-31]
RB-01/3d-synthview-7162277/files/RB01.05_-_Distanziali_Base_Meshed.stl
7.53 x 7.54 x 14.0
