xiaprojects/rb-cases/RB-Cockpits/six-pack-trainer/files/six-pack-trainer-C1.stl

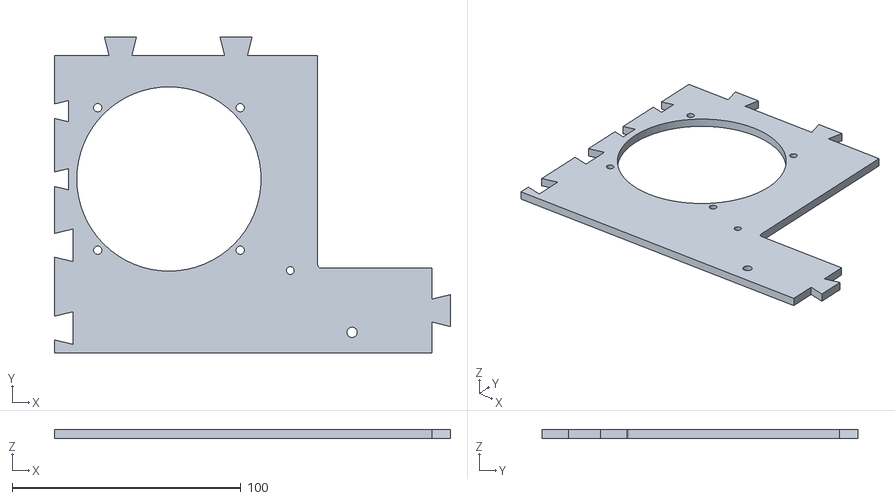
[picture p170: CAD file, 2026-10-31]
RB-Cockpits/six-pack-trainer/files/six-pack-trainer-C1.stl
173.0 x 138.0 x 4.00
