xiaprojects/rb-cases/RB-Cockpits/six-pack-trainer/files/six-pack-trainer-B2.stl

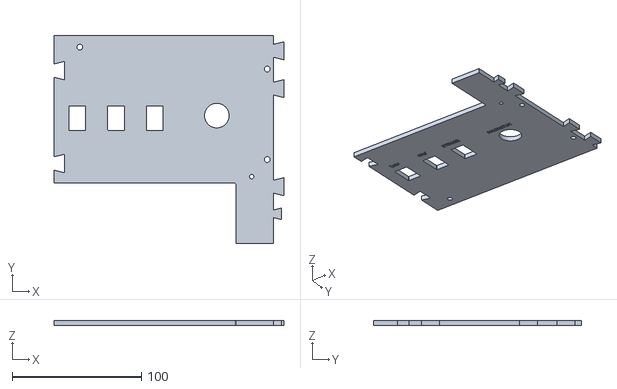
[picture p173: CAD file, 2026-10-31]
RB-Cockpits/six-pack-trainer/files/six-pack-trainer-B2.stl
178.0 x 161.0 x 4.00
