xiaprojects/rb-cases/RB-01/3d-synthview-7162277/files/RB01.05_-_Fissaggio_power_Meshed.stl

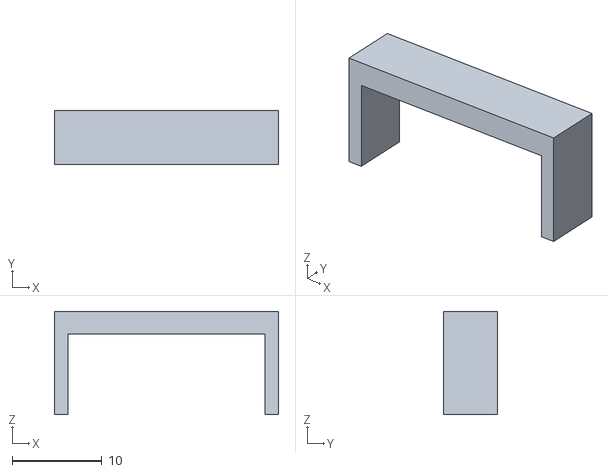
[picture p175: CAD file, 2026-10-31]
RB-01/3d-synthview-7162277/files/RB01.05_-_Fissaggio_power_Meshed.stl
25.0 x 6.00 x 11.5
