xiaprojects/rb-cases/RB-Cockpits/six-pack-trainer/files/six-pack-trainer-C2.stl

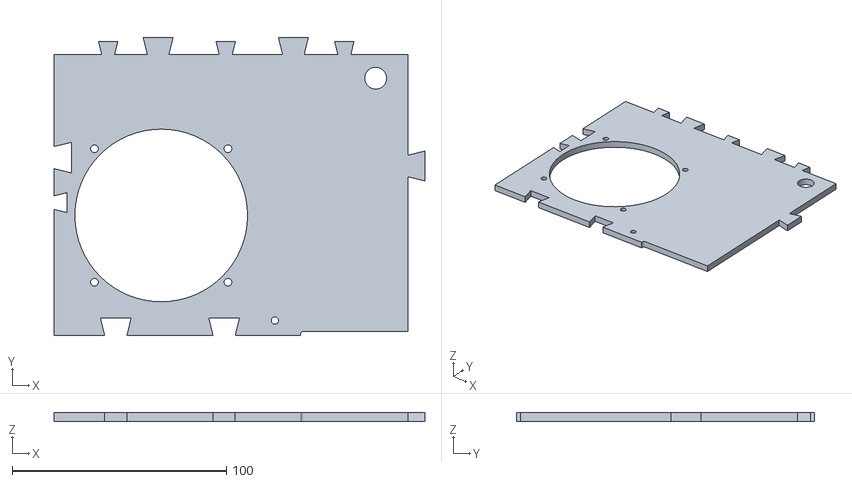
[picture p176: CAD file, 2026-10-31]
RB-Cockpits/six-pack-trainer/files/six-pack-trainer-C2.stl
173.0 x 139.0 x 4.00
