xiaprojects/rb-cases/RB-Cockpits/ultralight-rehearsal/files/ultralight-rehearsal.FCStd

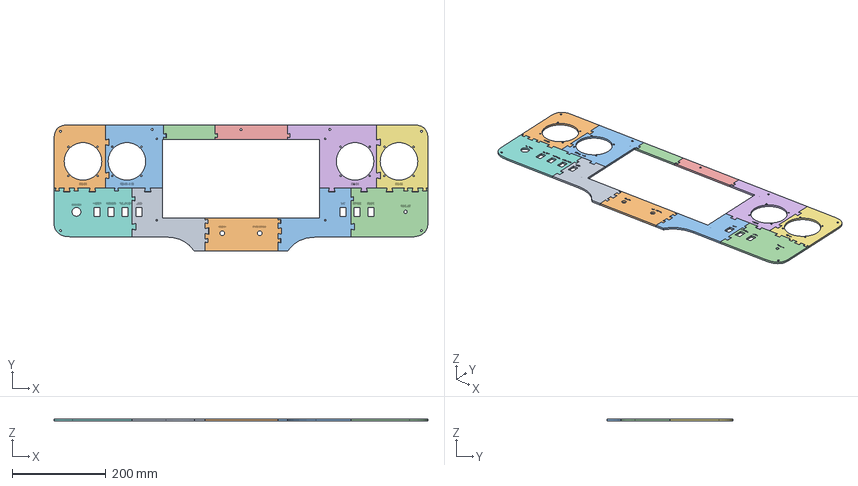
[picture p177: CAD file, 2026-10-31]
RB-Cockpits/ultralight-rehearsal/files/ultralight-rehearsal.FCStd
800.0 x 270.0 x 4.00 mm
Panel
Panel_A1
Panel_B1
Panel_C1
Panel_D1
Panel_E1
Panel_F1
Panel_A2
Panel_B2
Panel_C2
Panel_D2
Panel_E2
