xiaprojects/rb-cases/RB-01/3d-synthview-7162277/files/RB01.05_-_Frontalino_Meshed.stl

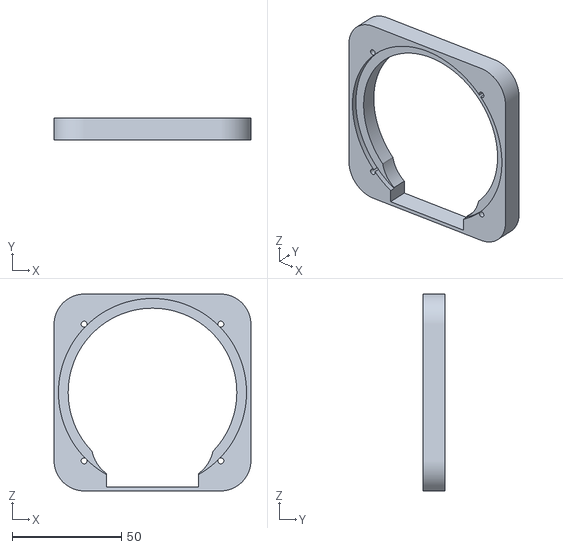
[picture p178: CAD file, 2026-10-31]
RB-01/3d-synthview-7162277/files/RB01.05_-_Frontalino_Meshed.stl
90.0 x 10.0 x 90.0
