xiaprojects/rb-cases/RB-Cockpits/six-pack-trainer/files/six-pack-trainer-E1.stl

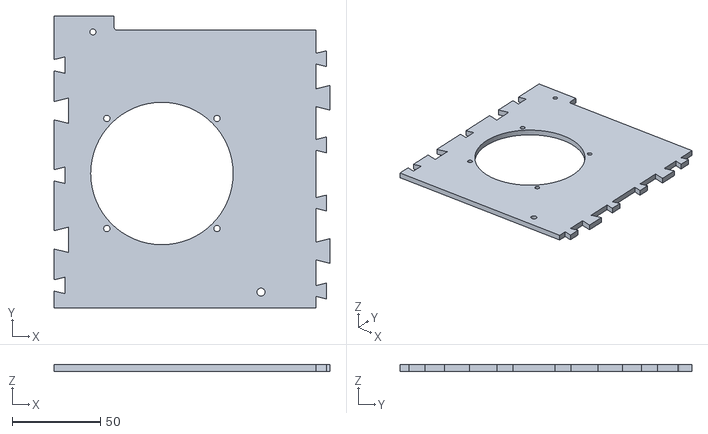
[picture p179: CAD file, 2026-10-31]
RB-Cockpits/six-pack-trainer/files/six-pack-trainer-E1.stl
156.0 x 165.0 x 4.00
