xiaprojects/rb-cases/RB-Cockpits/six-pack-trainer/files/six-pack-trainer-D2.stl

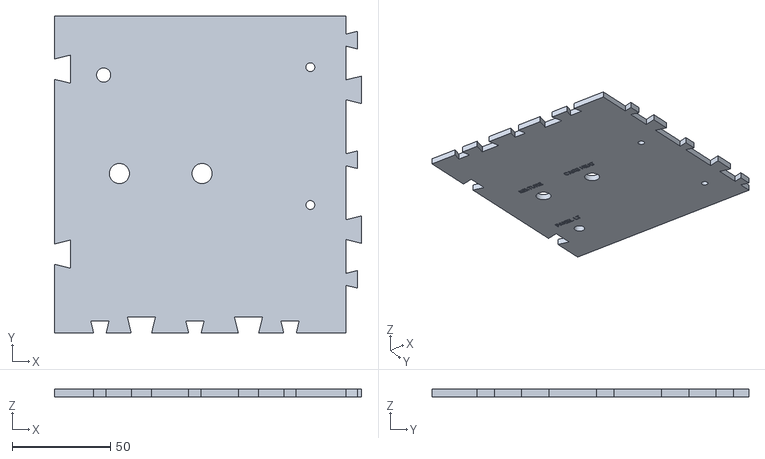
[picture p182: CAD file, 2026-10-31]
RB-Cockpits/six-pack-trainer/files/six-pack-trainer-D2.stl
156.0 x 161.0 x 4.00
