xiaprojects/rb-cases/RB-Cockpits/six-pack-trainer/files/six-pack-trainer-A2.stl

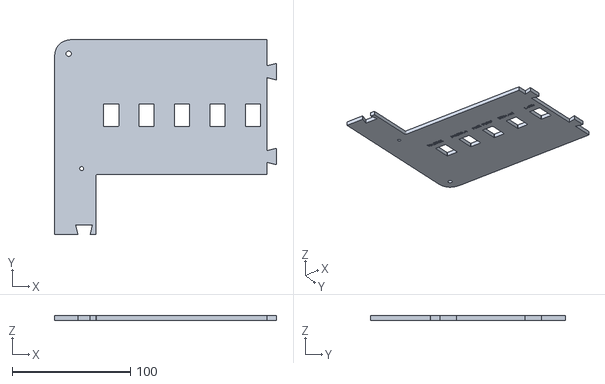
[picture p184: CAD file, 2026-10-31]
RB-Cockpits/six-pack-trainer/files/six-pack-trainer-A2.stl
188.0 x 165.0 x 4.00
