xiaprojects/rb-cases/(list of files, cad)

Other CAD files:
RB-02/parrot-gps-sixpack-box-80mm-7208654/files/RB02B_-_1.02_-_80mm.stl
RB-06/printed-case-waveshare-8/files/rb06-8dp-carrier.stl
RB-Cockpits/ultralight-rehearsal/files/ultralight-rehearsal-D2.stl
RB-Cockpits/glass-cockpit-rig/files/glass-cockpit-rig-right-C2.stl
RB-Cockpits/glass-cockpit-rig/files/glass-cockpit-rig-left-C2.stl
RB-Cockpits/desktop-pod/files/desktop-pod.dxf
RB-Cockpits/glider-panel/files/glider-panel.dxf
RB-Cockpits/six-pack-trainer/files/six-pack-trainer.dxf
RB-Cockpits/ultralight-rehearsal/files/ultralight-rehearsal.dxf
