xiaprojects/rb-cases/RB-02/front-install-sixpack-box-80mm-7103368/README.md

# RB-02 Front Install Avionics SixPack Box 80mm

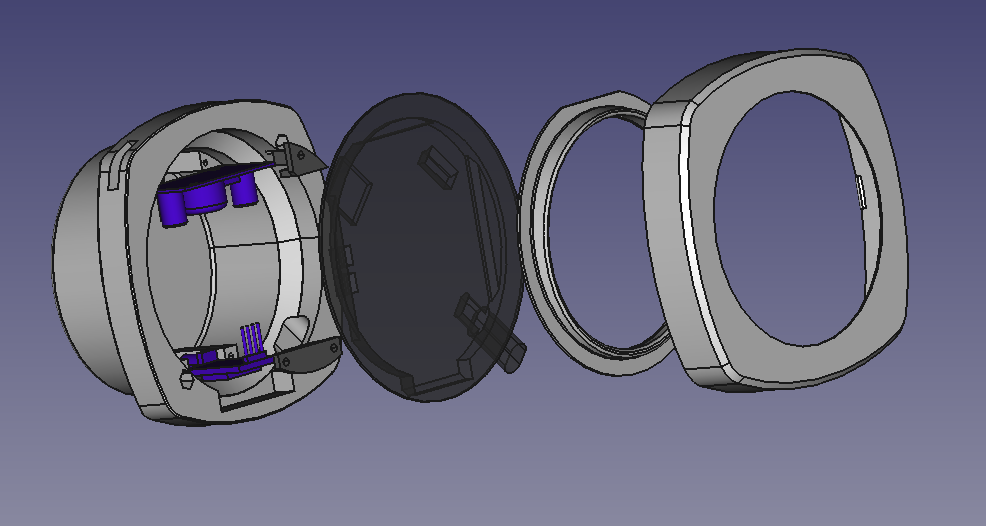
[picture p209: RB-02/front-install-sixpack-box-80mm-7103368/images/RB02_Assembly.png]
RB-02 Front Install Avionics SixPack Box 80mm


| | |
|---|---|
| Thingiverse | [thing:7103368](https://www.thingiverse.com/thing:7103368) |
| Author | XIAPROJECTS |
| License | Free for personal use; commercial use requires an agreement, see [LICENSE.md](../../LICENSE.md) |

> **Printing for an aircraft:** the parts must withstand 100 °C in cruise on long flights. Read [PRINTING.md](../../PRINTING.md) for the materials and the test before printing.

## Description

RB-02 is the new Touch Screen Avionics for Experimental and Ultralight aircraft.

This mount install is from FRONTAL installation, this will simplify the building process of the instrument.

You can follow the build tutorial here: <https://github.com/xiaprojects/rb-esp/wiki>

To have commercial license send a private message.

<!-- BEGIN parts: generated by tools/import-thing.sh, do not edit by hand -->
## Parts

| File | Size | Preview |
|---|---:|---|
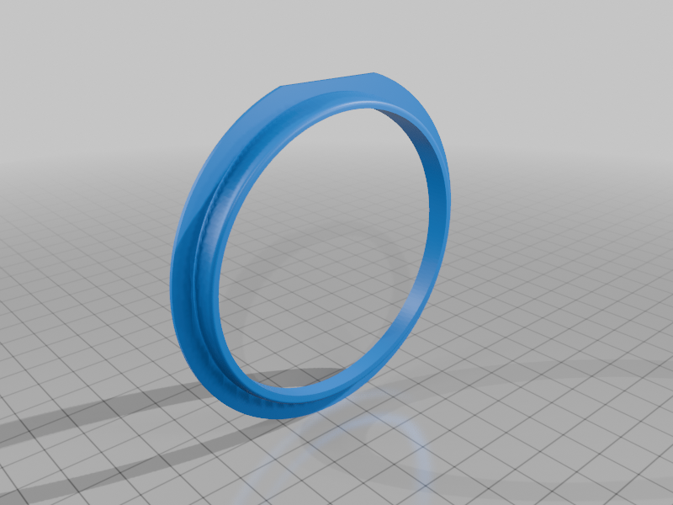
[picture p210: RB-02/front-install-sixpack-box-80mm-7103368/images/RB02C_-_front_ring_Meshed.png]
| [RB02C_-_front_ring_Meshed.stl](files/RB02C_-_front_ring_Meshed.stl) | 1.0 MB |  |
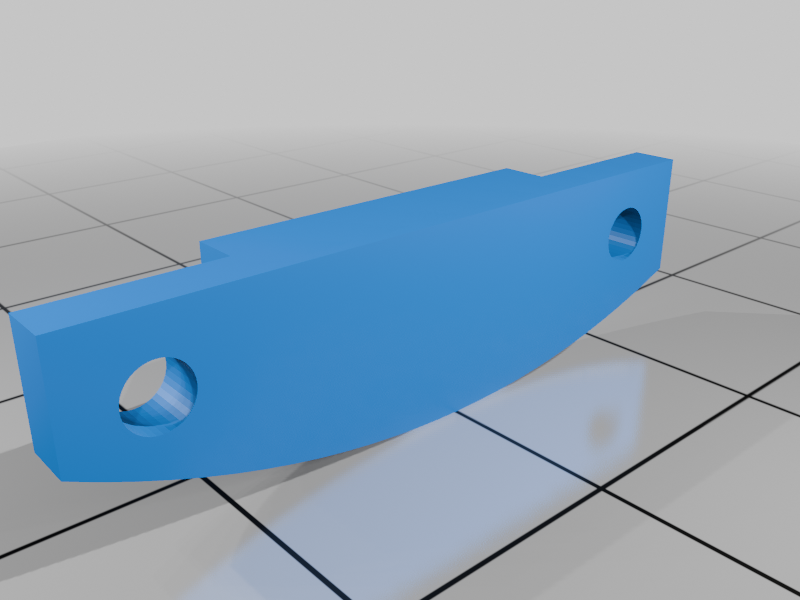
[picture p211: RB-02/front-install-sixpack-box-80mm-7103368/images/RB02C_-_GPS_lock_Meshed.png]
| [RB02C_-_GPS_lock_Meshed.stl](files/RB02C_-_GPS_lock_Meshed.stl) | 21 KB |  |
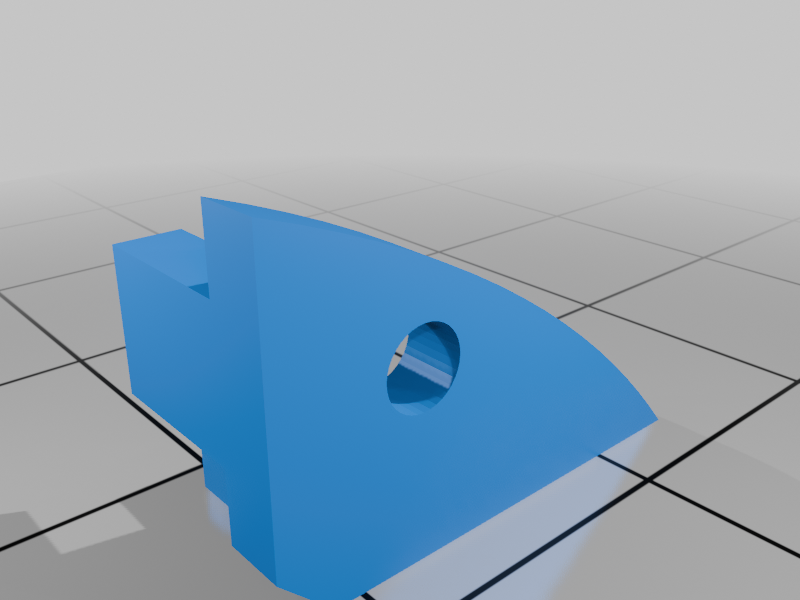
[picture p212: RB-02/front-install-sixpack-box-80mm-7103368/images/RB02C_-_power_lock_Meshed.png]
| [RB02C_-_power_lock_Meshed.stl](files/RB02C_-_power_lock_Meshed.stl) | 13 KB |  |
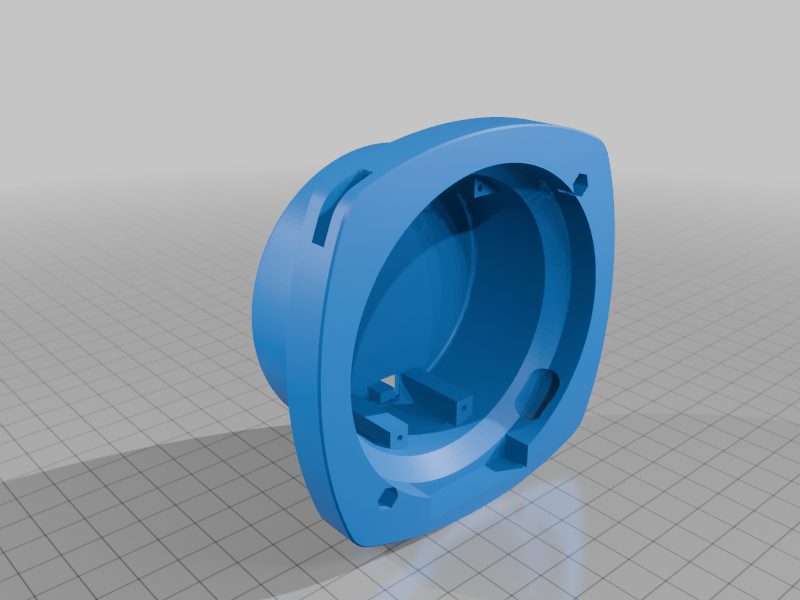
[picture p213: RB-02/front-install-sixpack-box-80mm-7103368/images/RB02D_-_case_Meshed.png]
| [RB02D_-_case_Meshed.stl](files/RB02D_-_case_Meshed.stl) | 1.1 MB |  |
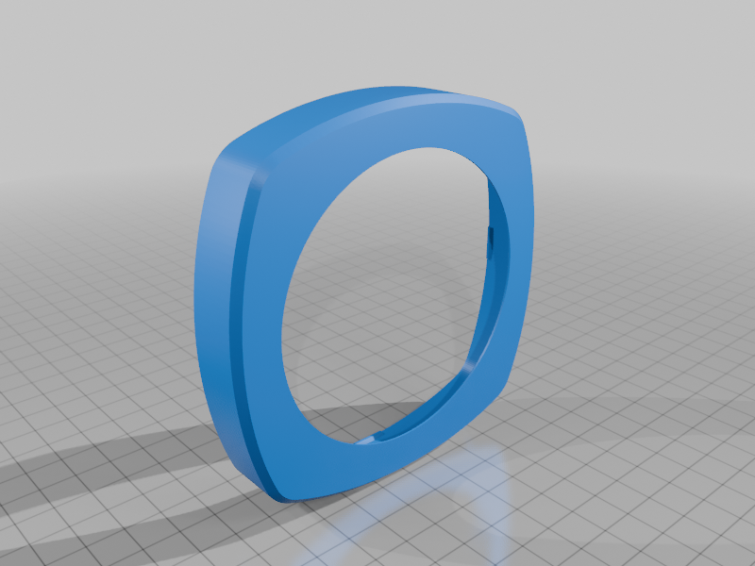
[picture p214: RB-02/front-install-sixpack-box-80mm-7103368/images/RB02D_-_front_panel_Meshed.png]
| [RB02D_-_front_panel_Meshed.stl](files/RB02D_-_front_panel_Meshed.stl) | 452 KB |  |
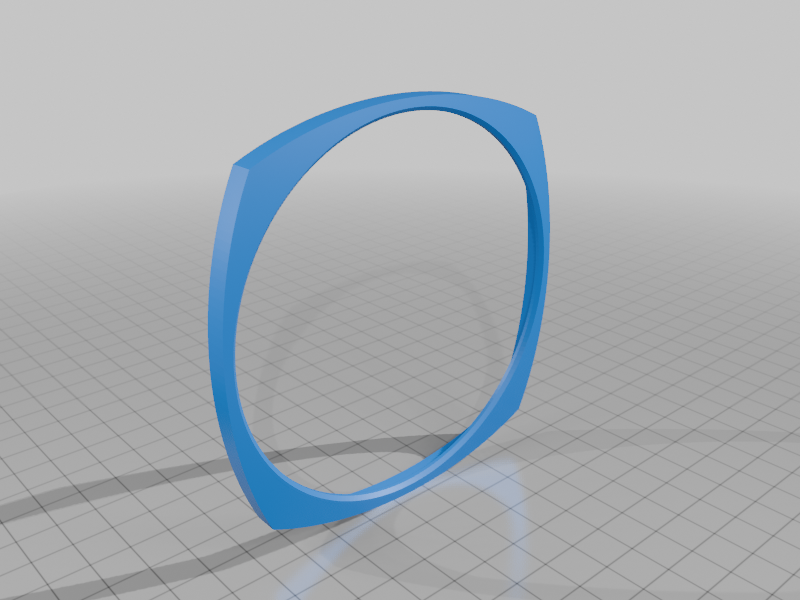
[picture p215: RB-02/front-install-sixpack-box-80mm-7103368/images/RB02D_-_template_ESP_Meshed.png]
| [RB02D_-_template_ESP_Meshed.stl](files/RB02D_-_template_ESP_Meshed.stl) | 156 KB |  |

## Photos


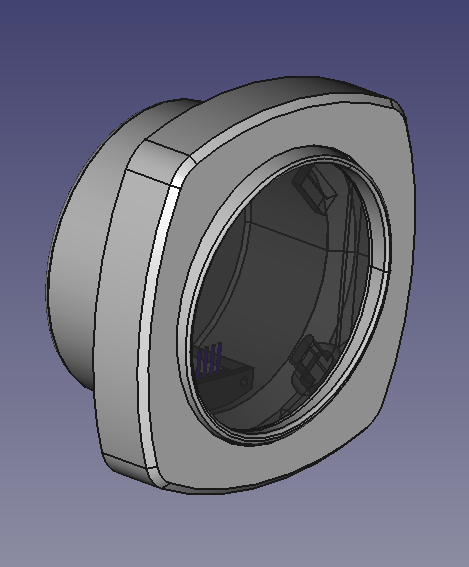
[picture p216: RB-02/front-install-sixpack-box-80mm-7103368/images/RB02-FRONT-INSTALL.png]

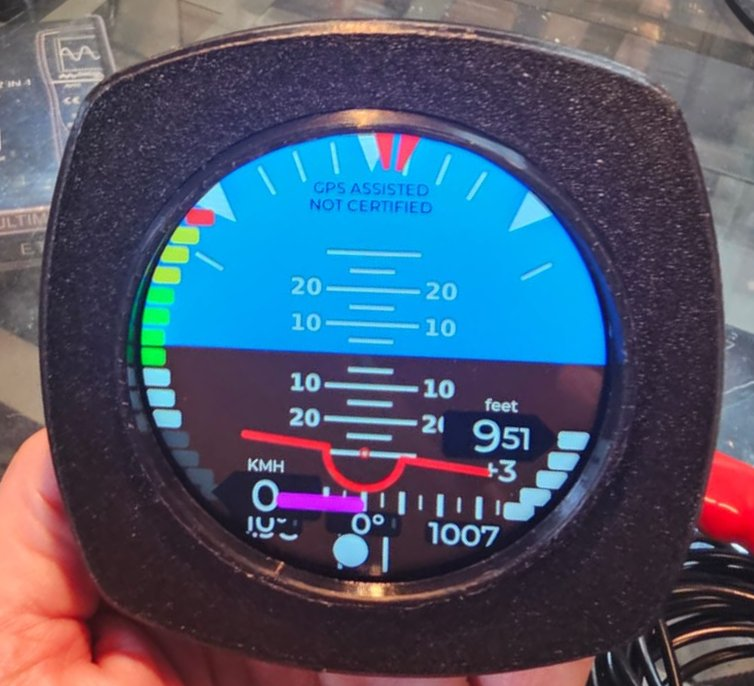
[picture p217: RB-02/front-install-sixpack-box-80mm-7103368/images/RB-02-Preview-Front.jpeg]

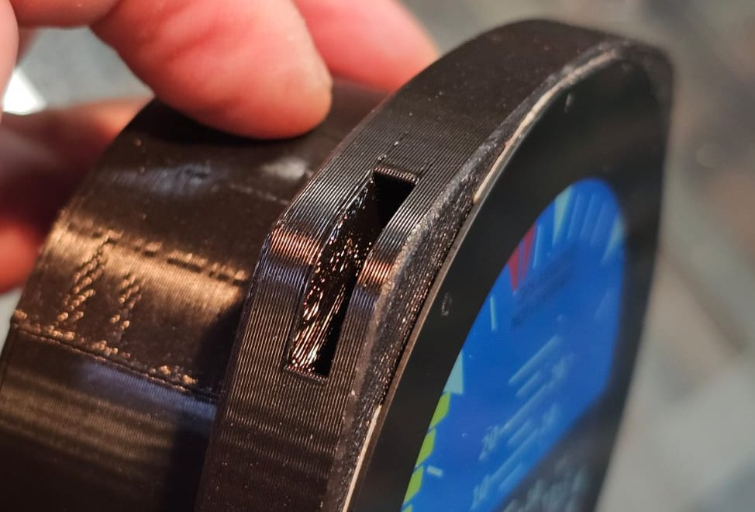
[picture p218: RB-02/front-install-sixpack-box-80mm-7103368/images/RB-02-Preview-SDCard.jpeg]

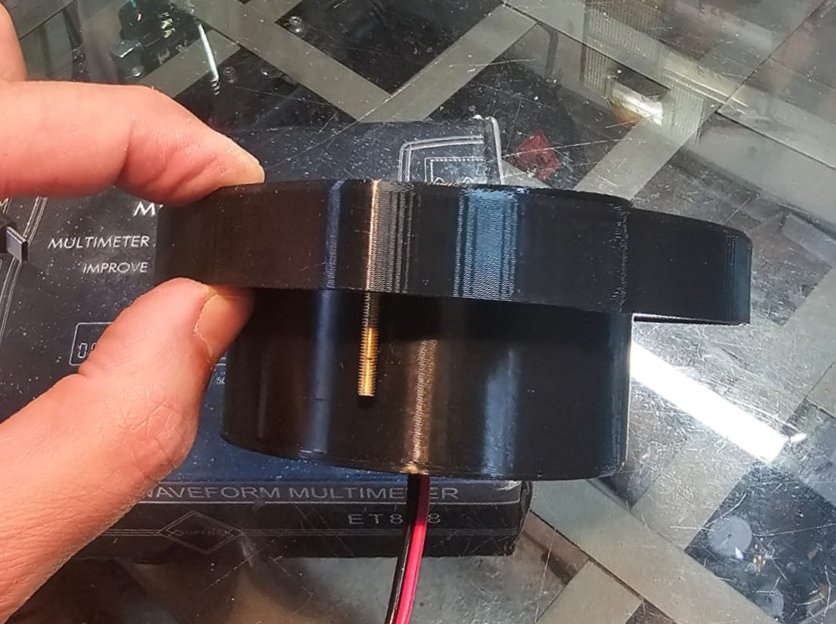
[picture p219: RB-02/front-install-sixpack-box-80mm-7103368/images/RB-02-Preview-Side.jpeg]

<!-- END parts -->

<!-- BEGIN kicad: generated by tools/kicad_templates.py, do not edit by hand -->
## KiCad board template

A KiCad project as the starting point for your own electronics.

RB-02 Front Install SixPack Box: round board

[kicad/rb02-front-install-board/rb02-front-install-board.kicad_pro](kicad/rb02-front-install-board/rb02-front-install-board.kicad_pro): A round 70 mm board inside the front-install case, on its three M2 bosses.

- Seen from the front (display side); the F side faces the display.
- The board sits on the boss faces 17 mm behind the front of RB02D_-_case, inside its 72 mm tube; the notch at the top left clears a block that stands 0.7 mm proud of them.
- The top right boss is 2 mm deeper: put a 2 mm spacer under the board there.
- 3 x M2 screws thread into the printed 1.8 mm pilots.
- Dwgs.User shows the case cut at the board plane.

<!-- END kicad -->
