xiaprojects/rb-cases/RB-01/3d-synthview-7162277/kicad/rb01-pi-hat/rb01-pi-hat.kicad_pcb

## KiCad design RB-01/3d-synthview-7162277/kicad/rb01-pi-hat/rb01-pi-hat.kicad_pcb (2026-10-31)


Board: 2 copper layers, 65.0 x 56.0 mm, 5 parts (1 on the bottom side), 3 nets, no tracks yet.

Parts:
J1: GPIO; PinSocket_2x20_P2.54mm_Vertical
MH1, MH2, MH3, MH4: MountingHole_2.7mm_M2.5

Connections:
+3V3: J1.1, J1.17
+5V: J1.2, J1.4
GND: J1.6, J1.9, J1.14, J1.20, J1.25, J1.30, J1.34, J1.39
