xiaprojects/rb-cases/(commit log)

2026-10-31 Add RB-Avionics cases, cockpit panels and KiCad board templates
    - Unpack the six Thingiverse exports into one folder per design, with a
    README.md for each (description, parts, photos, author, license)
    - RB-Avionics license (LICENSE.md): free for personal use, commercial use
    by agreement; the GPS mount V2 keeps SeeCoryRun's CC BY-SA
    - PRINTING.md: disclaimer and the 100 °C material requirement for parts
    that fly, linked from every printable design
    - RB-Cockpits: 3D-printable panels for the five home cockpits of
    www.rbavionics.com, tiled for a 200 mm bed with glued dovetails, plus
    DXF for laser or CNC cutting and the FreeCAD models
    - KiCad 9 board templates for every design, built f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
    [GPSmountN7v1.stl, GPSstandoffV2.stl, RB01.05_-_Base_A.rev_2_Meshed.stl, RB01.05_-_Base_A_Meshed.stl, RB01.05_-_Base_B_Meshed.stl, RB01.05_-_Distanziali_Base_Meshed.stl, RB01.05_-_Fissaggio_power_Meshed.stl, RB01.05_-_Flangia_Meshed.stl]
2026-11-01 Waveshare supported display cases #1
    [rb02-amoled175-cap.stl, rb02-amoled175-case.FCStd, rb02-amoled175-panel-cutout.dxf, rb02-amoled175-shell.stl, rb02-amoled241-bezel.stl, rb02-amoled241-carrier.stl, rb02-amoled241-case.FCStd, rb02-amoled241-gpio-board.kicad_pcb]
2026-11-07 RB-01 Glasscockpit with multiple display #2
    [rb01-glass-8-ahrs-board.kicad_pcb, rb01-glass-8-ahrs-board.kicad_sch, rb01-glass-8-bezel.stl, rb01-glass-8-carrier.stl, rb01-glass-8-case.FCStd, rb01-glass-8-panel-cutout.dxf, rb01-glass-8-rear-cover.stl, rb01-glass-round-cap.stl]
